dissakamajaya/cp-100/work/component-photos/esp32.jpg

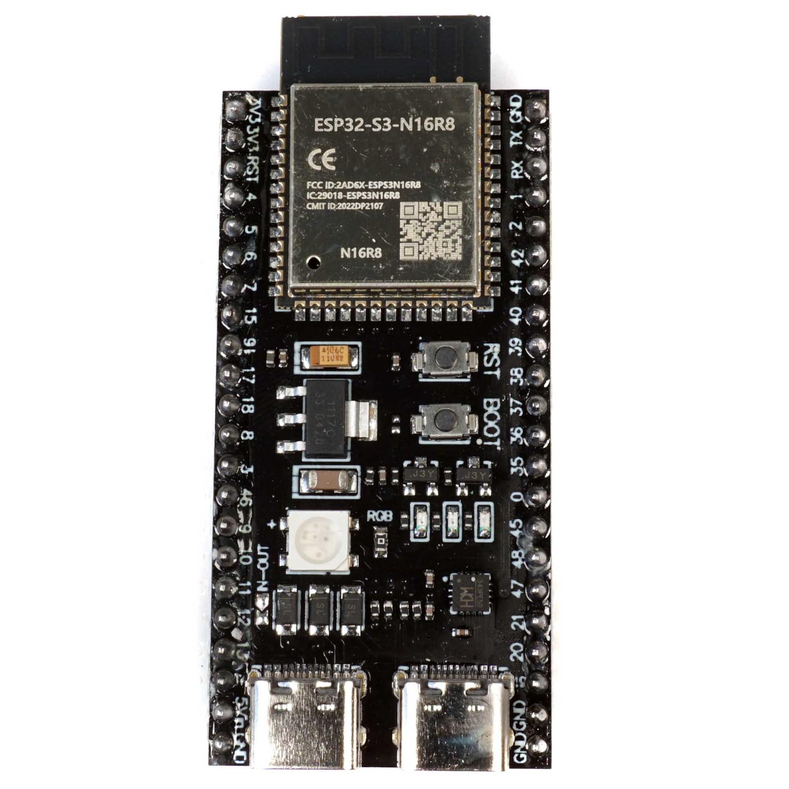
work/component-photos/esp32.jpg
