dissakamajaya/cp-100/work/component-photos/selector.jpg

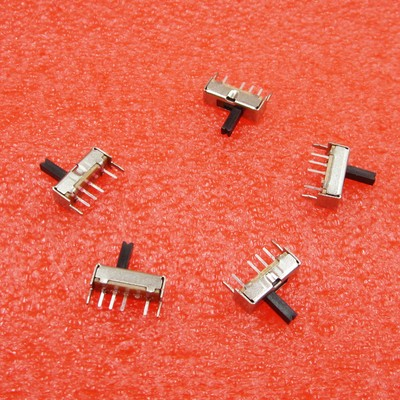
work/component-photos/selector.jpg
