dissakamajaya/cp-100/evidence/README.md

# Evidence

`packaging-verification.json` records verification on 26 October 2026: 29/29 Node tests, 80 source asset checksums, 32 photo path resolutions, and a successful isolated PDF rebuild (14 pages, 25 cutout features). All rebuilt page text matched the original. The original PDF remains packaged to preserve the exact incomplete revision.

No current live UI or physical hardware validation was performed. `historical/` contains previous-session QA artifacts and is not a new test result. The old QA script paths referenced in historical JSON belong to the source workspace; consult HANDOFF.md and rerun with Stagehand for current browser evidence.
