dissakamajaya/cp-100/evidence/enclosure-4-pad-2026-10-30/README.md

# Four-pad enclosure verification — 30 October 2026

Geometry PASS: node evidence/enclosure-4-pad-2026-10-30/verify-geometry.mjs; artifact geometry-results.json. Seven printable part types are valid single solids, STL byte counts pass, four caps have no housing/neighbour collision, service geometry unchanged.

Preview PASS: stagehand-run /Users/0xtx/Documents/GitHub/cp-100/evidence/enclosure-4-pad-2026-10-30/verify-preview.mjs (server: node enclosure/serve.mjs 5181). Stagehand completed; assembled and exploded images visually inspected. Artifacts retained: pad-assembled.png, pad-exploded.png. Front/underside screenshots discarded to recover space after filesystem became full during final notes.

Baseline PASS before editing: node --test simulator/tests/*.test.js domain-router/worker.test.mjs (44/44); python3 scripts/verify_manifest.py (86 assets, rechecked after edits). Existing working-tree changes preserved.

Result: four pads, default 2×2, 124×122×24 mm housing; faces 40×40 mm; pitch 48 mm. ZIP: enclosure/CP-100-4-pad-STLs.zip. One cap mesh: print four copies. Eight-pad STLs archived under enclosure/stl/legacy-8-pad/.

No physical print/hardware verification. Firmware, simulator and PDF remain eight-pad. No commit, push or deployment.
