dissakamajaya/cp-100/outputs/CP-100-Rev08-Blueprint/README.txt

CP-100 REV08 - REFERENCE PROTOTYPE
Units mm. SVG and A3 PDF front view: origin top-left; X right, Y down. DXF uses bottom-left, Y up. CUT layer includes panel perimeter and holes; no kerf compensation.
Panel material: 2mm black aluminium. Cutouts +/-0.2mm; centers +/-0.2mm proposed. Deburr; match units before full fabrication.
Custom cap, frame, spring, carrier and PCB need prototype fit checks. This package does not include Gerbers or production-ready 3D parts. See main PDF for assembly stack and part basis.
