dissakamajaya/cp-100/outputs/CP-100-Rev08-Blueprint/CP-100-Panel-Templates-1to1-A3.pdf

### CP-100 / VISITOR / REV08 / mm / 1:1

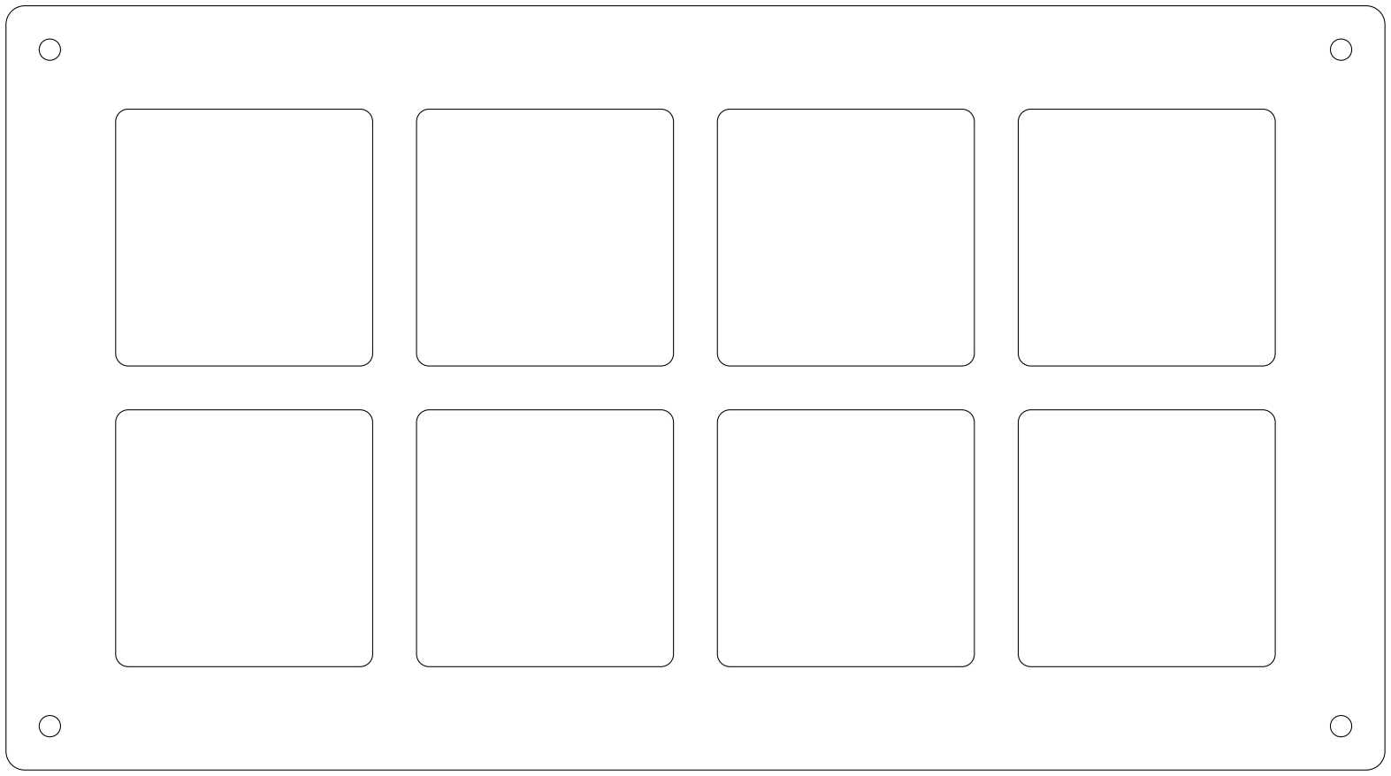
[picture p3: figure]

CHECK 50 x 50 mm

Print 100% / Actual size. No Fit to page. Front view, datum top-left.

Prototype reference. Match actual components before cutting.

### CP-100 / SERVICE / REV08 / mm / 1:1

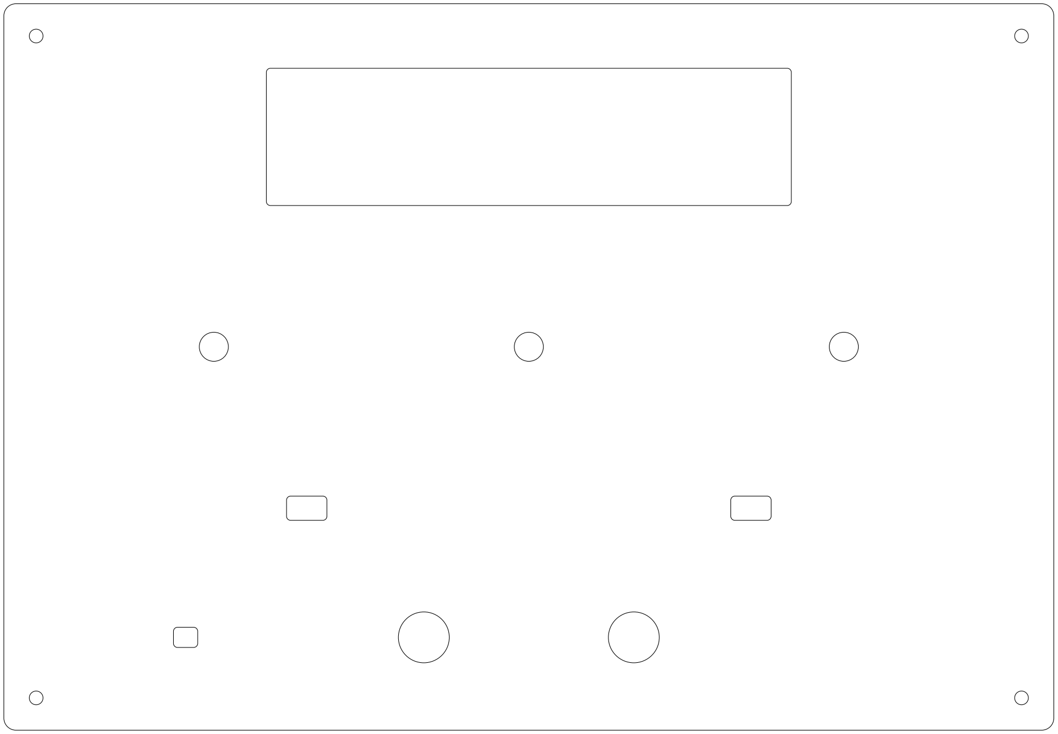
[picture p4: figure]

CHECK 50 x 50 mm

Print 100% / Actual size. No Fit to page. Front view, datum top-left.

Prototype reference. Match actual components before cutting.
