dissakamajaya/cp-100/evidence/audio-boost-2026-10-26/live-before.png

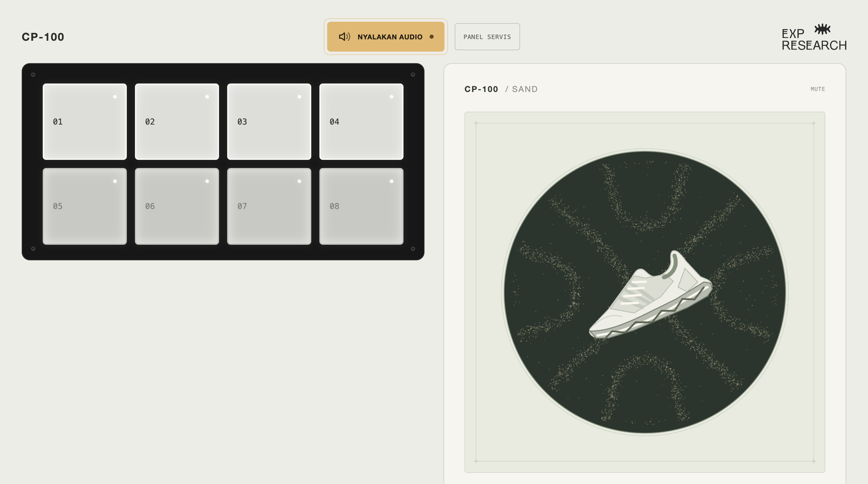
evidence/audio-boost-2026-10-26/live-before.png
