dissakamajaya/cp-100/evidence/diagram-esp32-2026-10-26/artifact.png

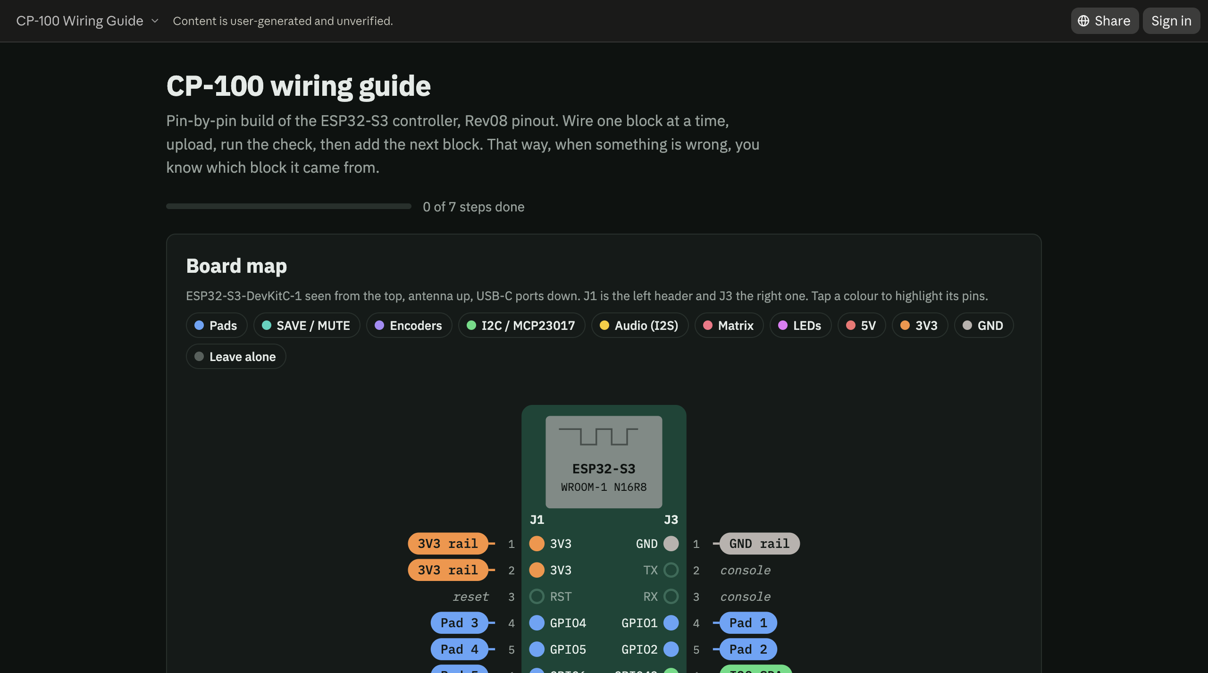
evidence/diagram-esp32-2026-10-26/artifact.png
