dissakamajaya/cp-100/evidence/enclosure-4-pad-2026-10-30/pad-exploded.png

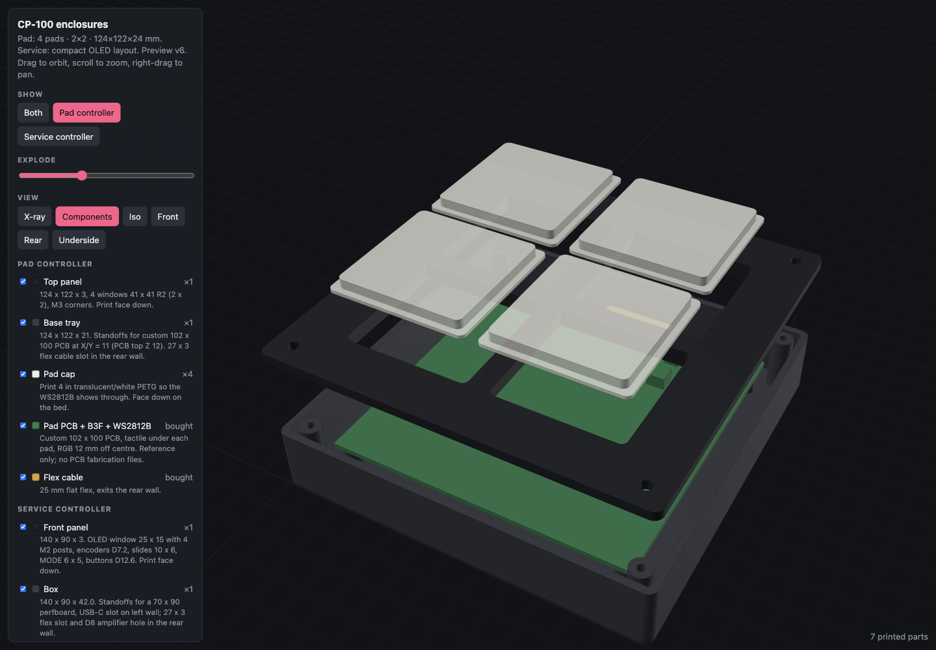
evidence/enclosure-4-pad-2026-10-30/pad-exploded.png
