dissakamajaya/cp-100/evidence/enclosure-4-pad-row-2026-10-30/pad-underside.png

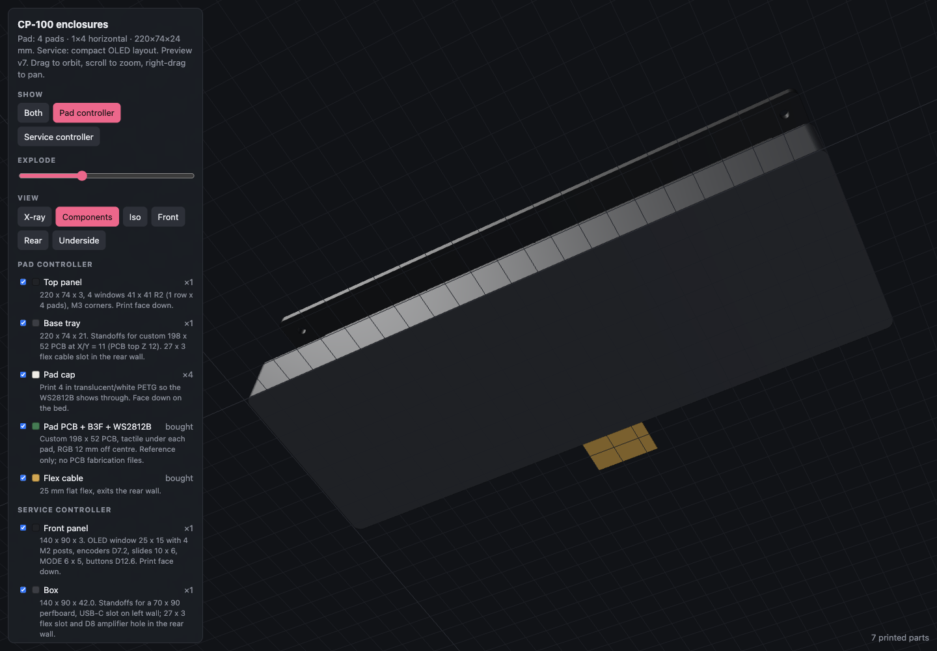
evidence/enclosure-4-pad-row-2026-10-30/pad-underside.png
