dissakamajaya/cp-100/evidence/enclosure-2026-10-27/preview-pad-underside.png

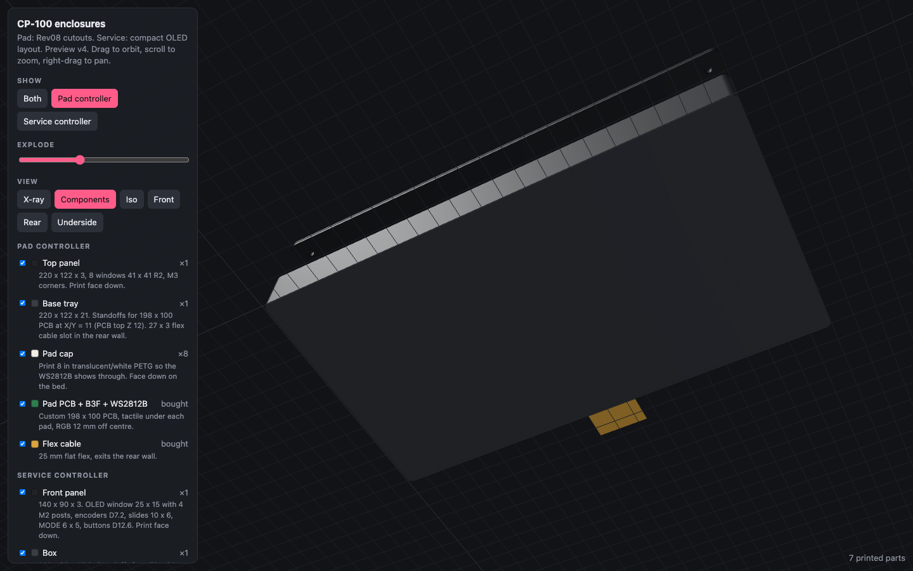
evidence/enclosure-2026-10-27/preview-pad-underside.png
