dissakamajaya/cp-100/evidence/gather-2026-10-28/live-mobile.png

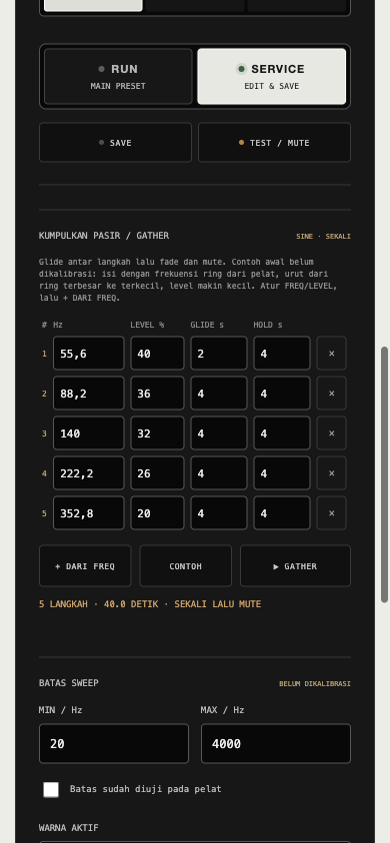
evidence/gather-2026-10-28/live-mobile.png
