dissakamajaya/cp-100/evidence/historical/domain-route/domain-smoke.png

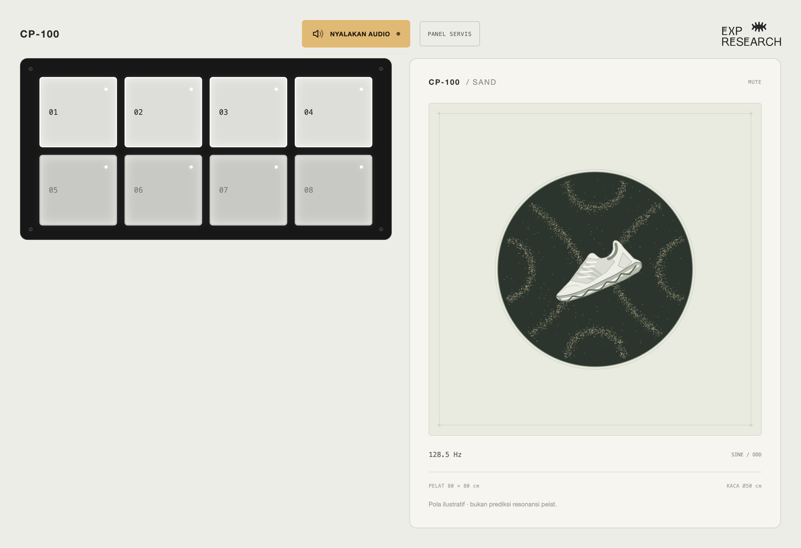
evidence/historical/domain-route/domain-smoke.png
