dissakamajaya/cp-100/evidence/historical/domain-route/momentary-held.png

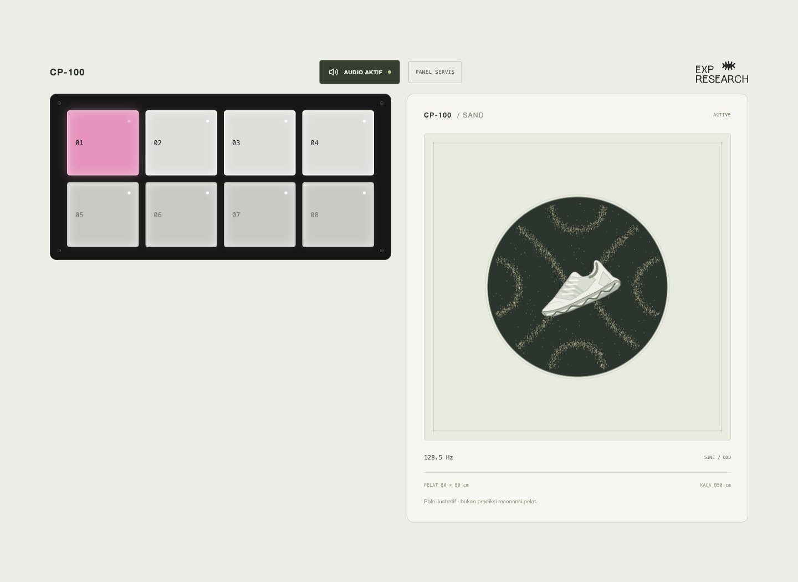
evidence/historical/domain-route/momentary-held.png
