dissakamajaya/cp-100/evidence/historical/domain-route/momentary-mobile.png

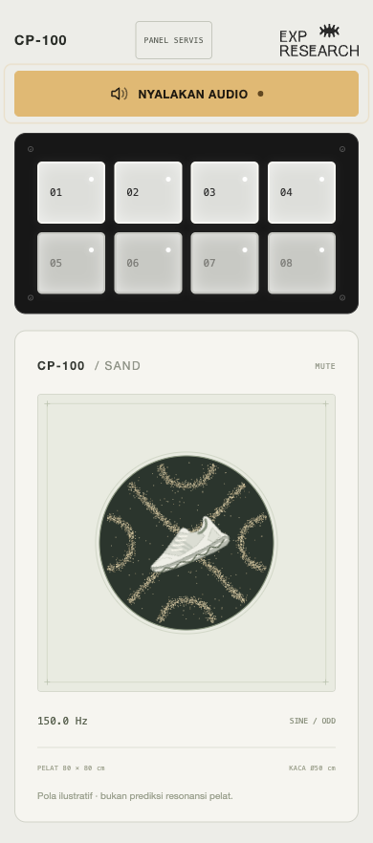
evidence/historical/domain-route/momentary-mobile.png
