dissakamajaya/cp-100/evidence/historical/rev7-review/mobile.png

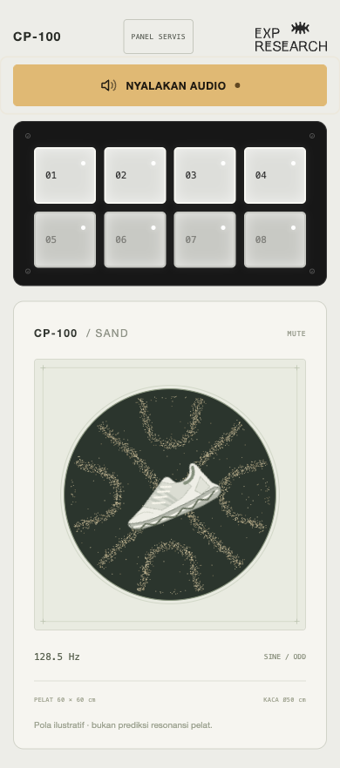
evidence/historical/rev7-review/mobile.png
