dissakamajaya/cp-100/evidence/momentary-2026-11-01/mobile-presets.png

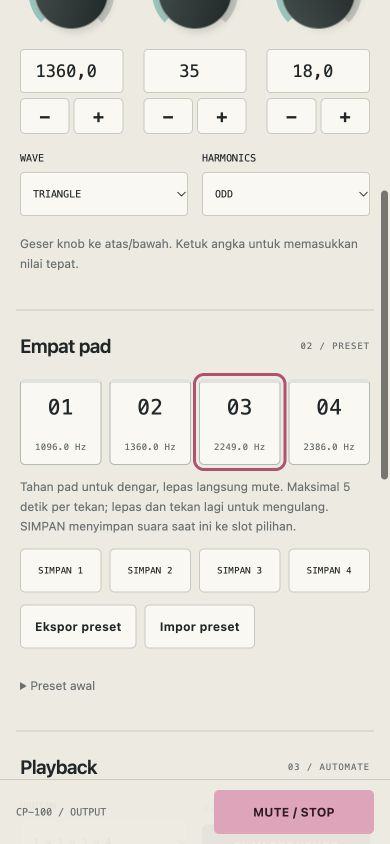
evidence/momentary-2026-11-01/mobile-presets.png
