dissakamajaya/cp-100/evidence/momentary-2026-11-01/pdf-6.png

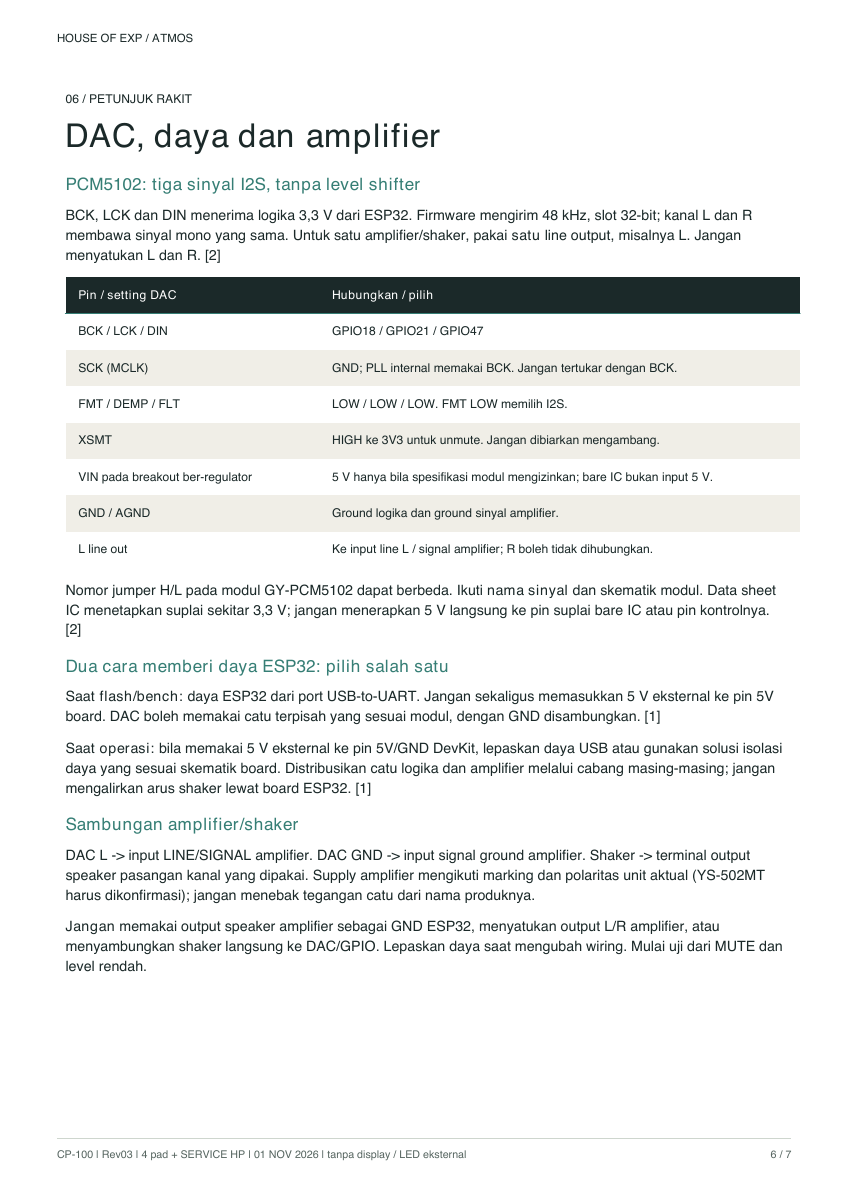
evidence/momentary-2026-11-01/pdf-6.png
