dissakamajaya/cp-100/evidence/release-2026-11-01/mobile-minimal.png

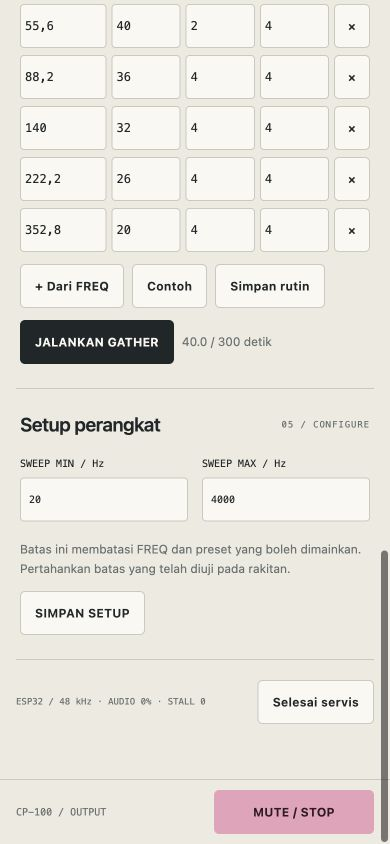
evidence/release-2026-11-01/mobile-minimal.png
