dissakamajaya/cp-100/evidence/remote-service-2026-10-31/mobile-panel-final.png

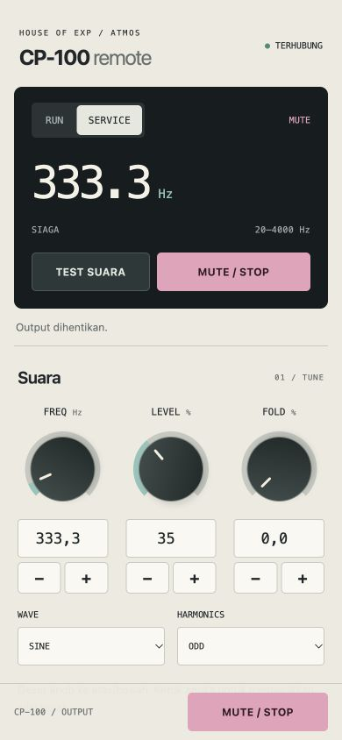
evidence/remote-service-2026-10-31/mobile-panel-final.png
