dissakamajaya/cp-100/evidence/sequencer-2026-10-26/live-desktop.png

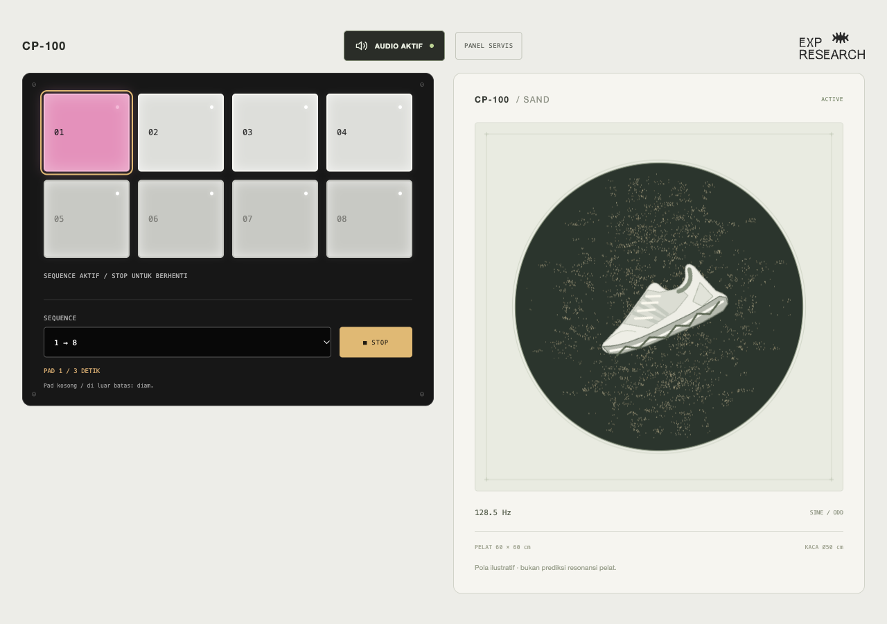
evidence/sequencer-2026-10-26/live-desktop.png
