dissakamajaya/cp-100/outputs/Chladni-08-Visual-Rev03.png

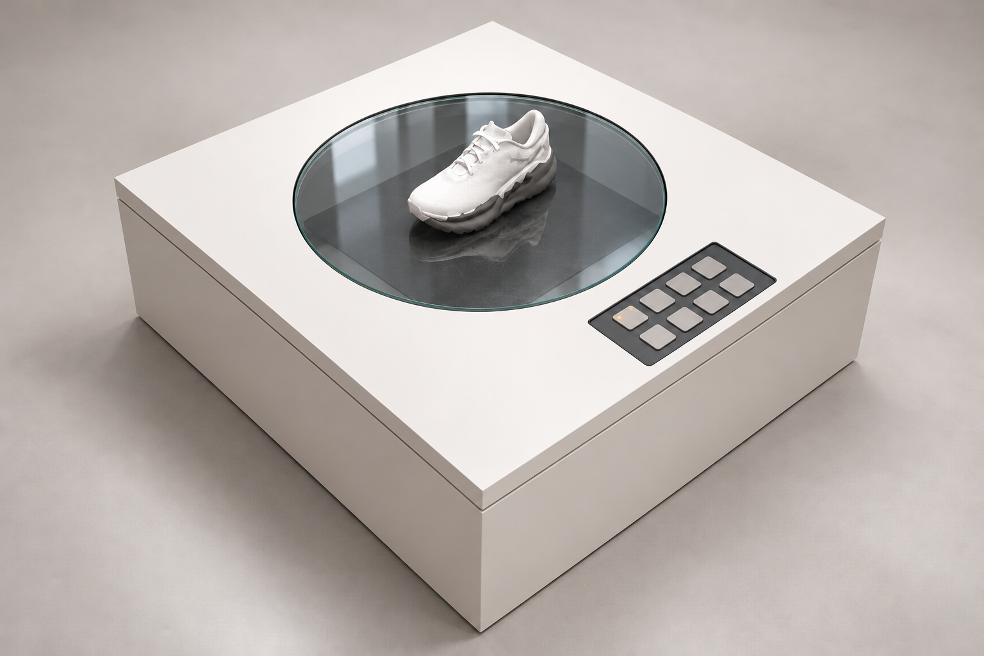
outputs/Chladni-08-Visual-Rev03.png
