dissakamajaya/cp-100/work/rev8/final-contact-0.png

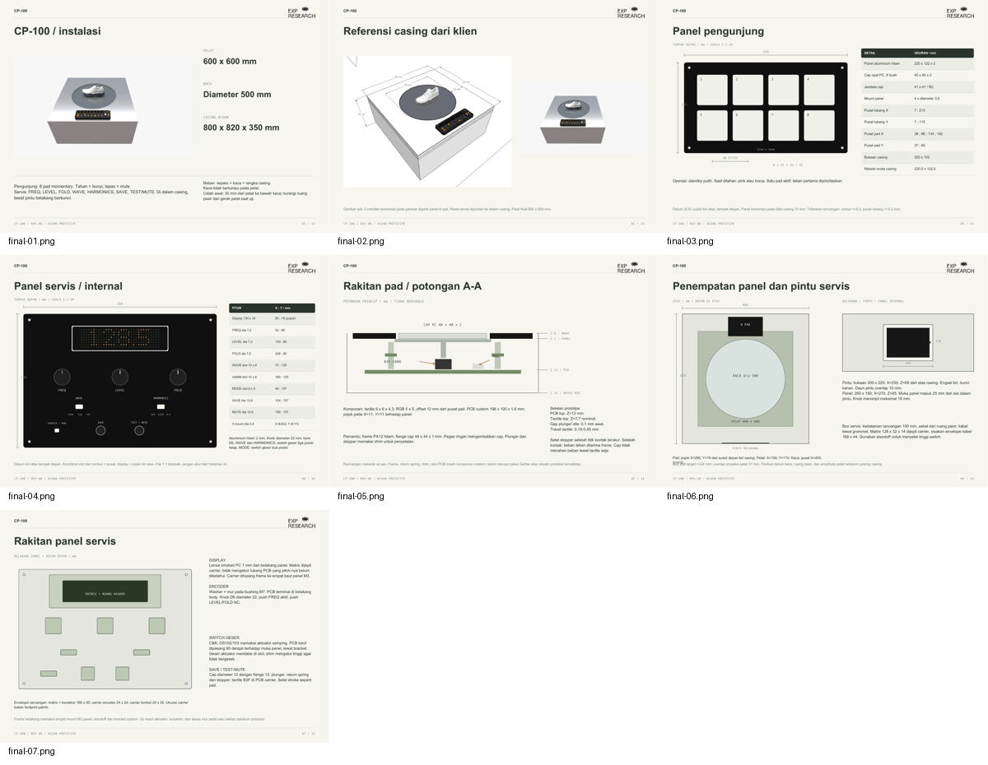
work/rev8/final-contact-0.png
