dissakamajaya/cp-100/work/rev8/final-contact-1.png

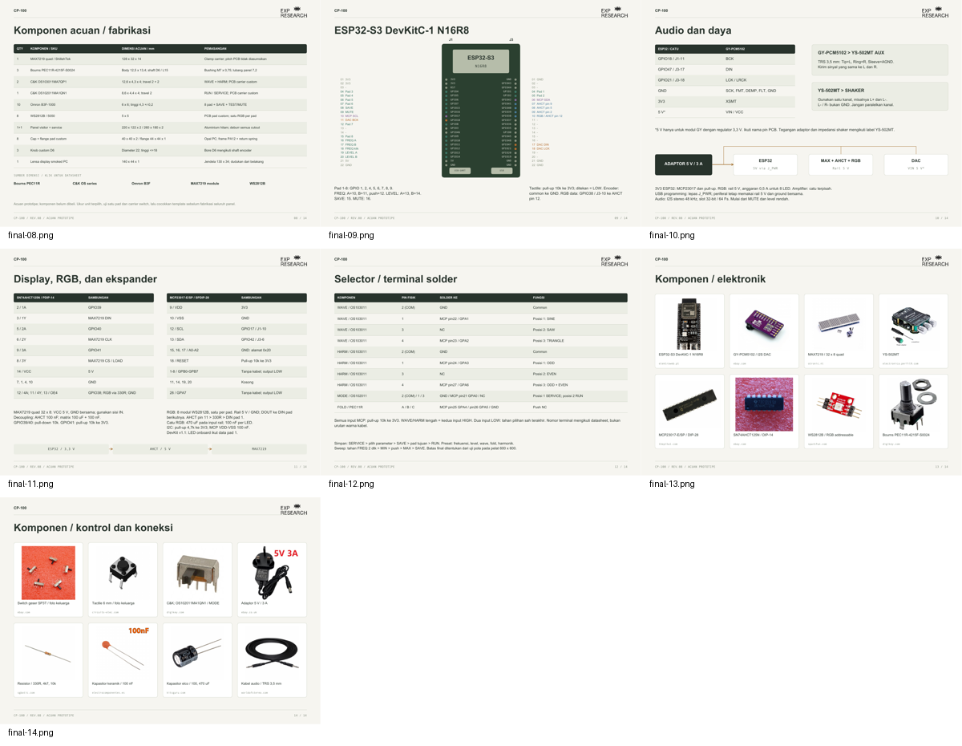
work/rev8/final-contact-1.png
