dissakamajaya/cp-100/work/rev8/reference-dimensions.png

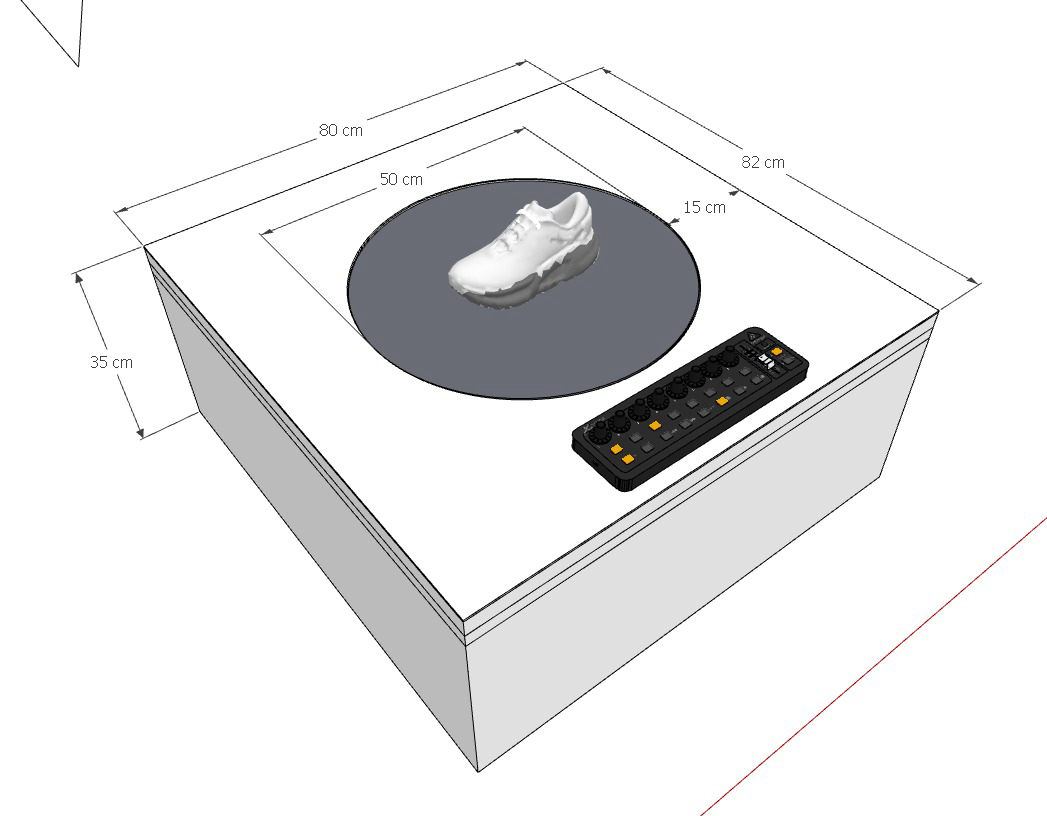
work/rev8/reference-dimensions.png
