dissakamajaya/cp-100/work/rev8/reference-render.png

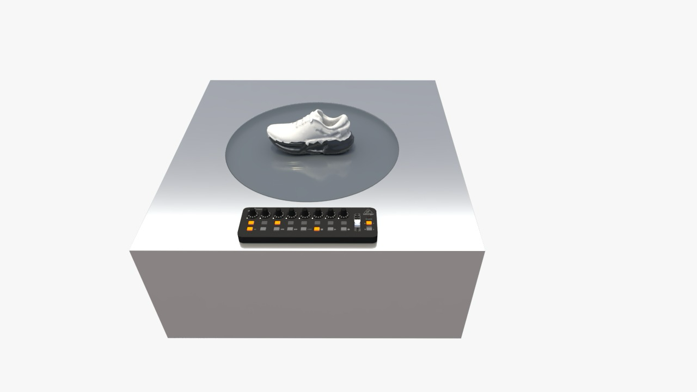
work/rev8/reference-render.png
