dissakamajaya/cp-100/work/rev8/sources/alps-08.png

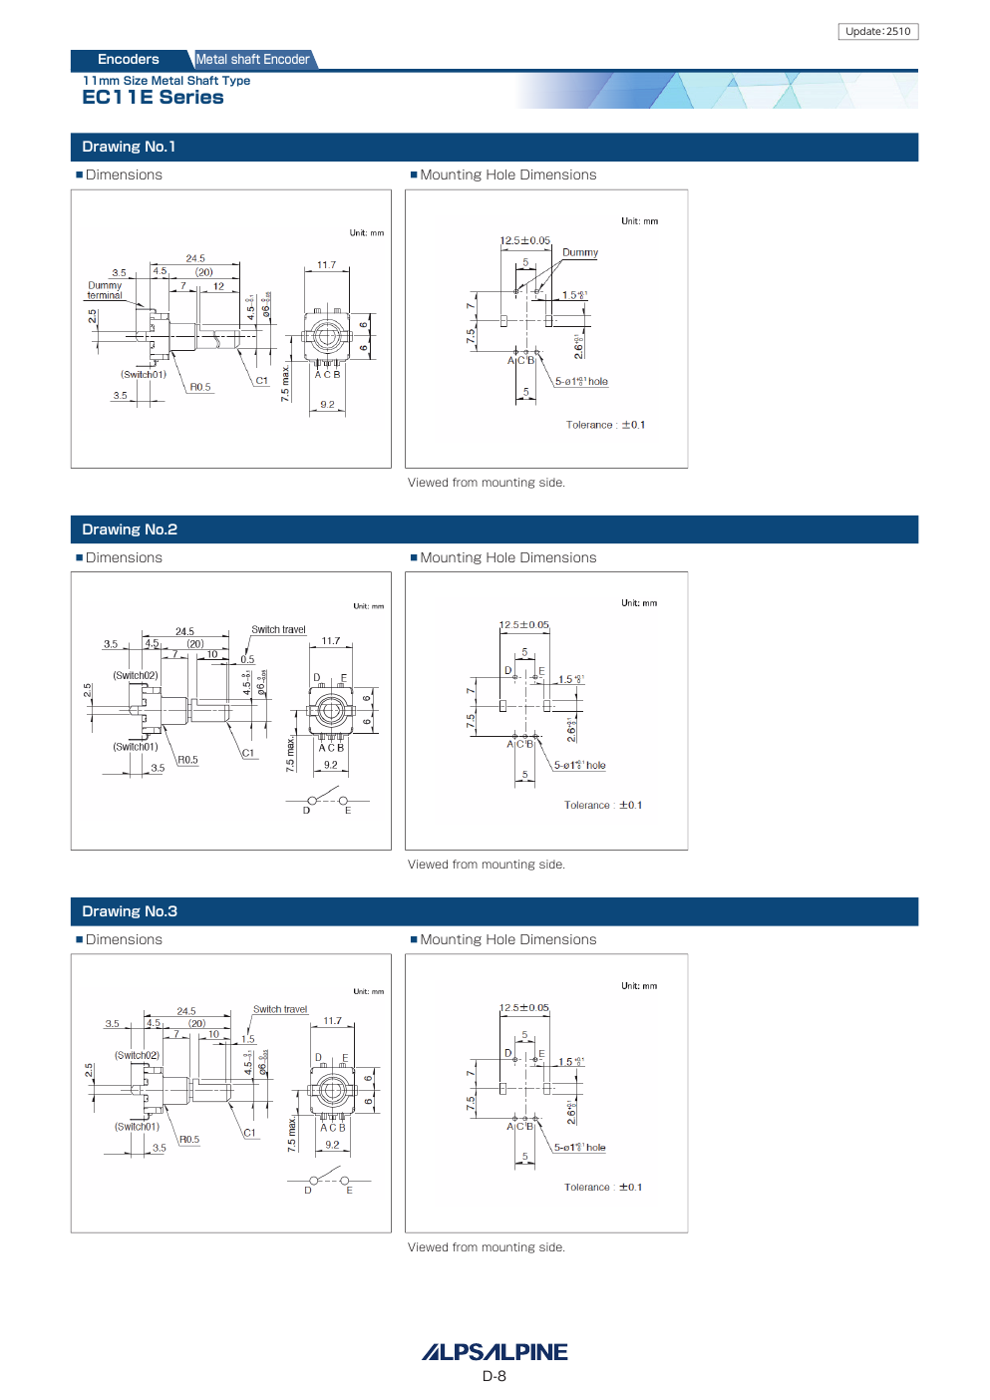
work/rev8/sources/alps-08.png
