dissakamajaya/cp-100/work/rev8/sources/bourns-1.png

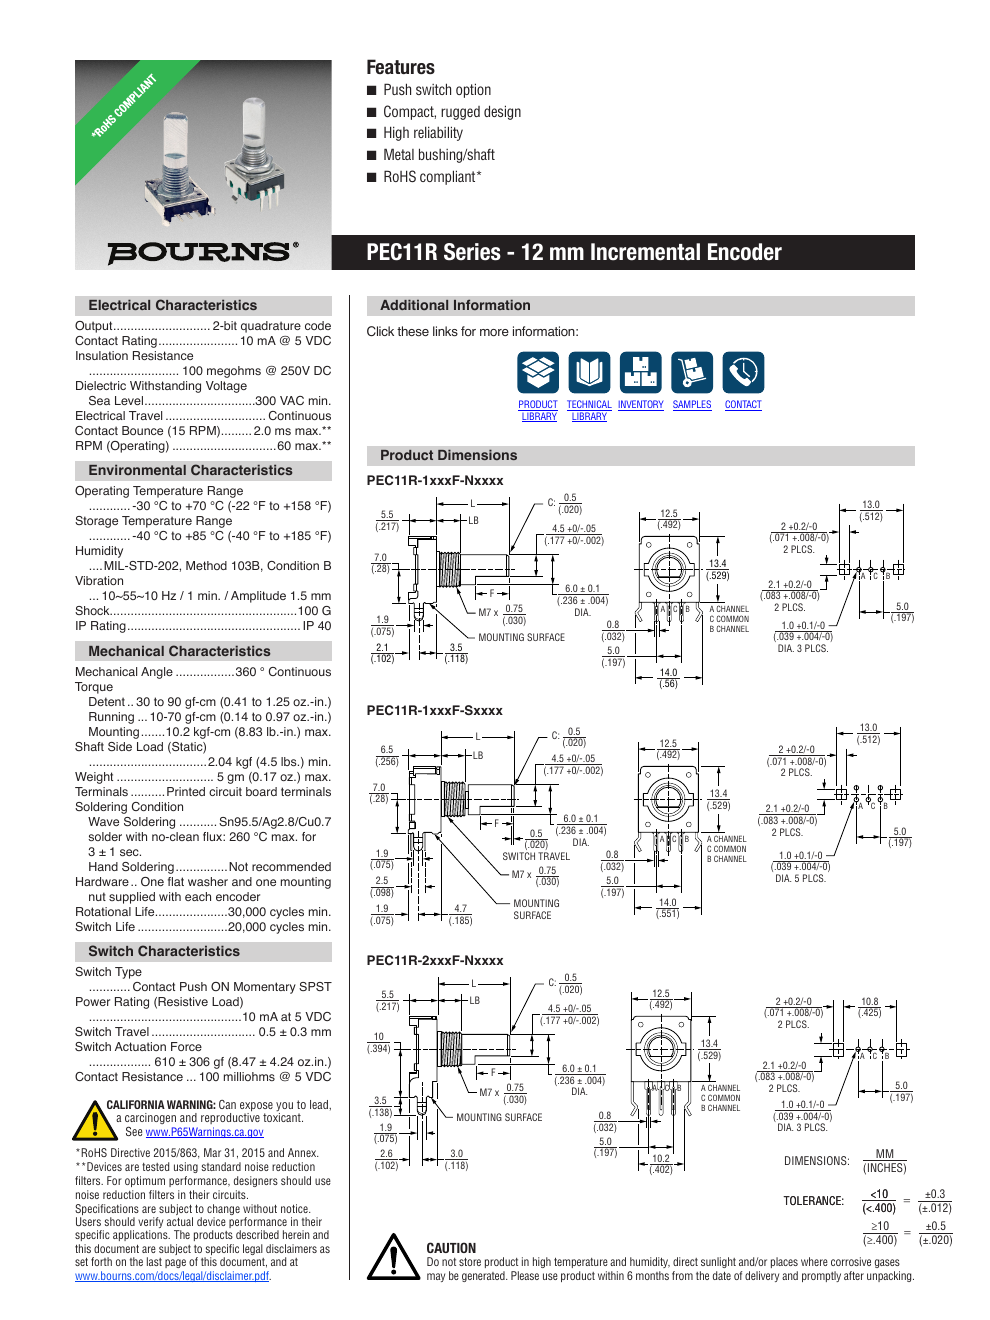
work/rev8/sources/bourns-1.png
