dissakamajaya/cp-100/work/rev8/sources/os102.jpg

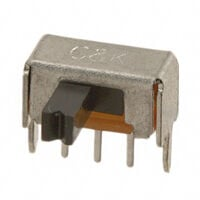
work/rev8/sources/os102.jpg
