dissakamajaya/cp-100/work/rev8/sources/pec11r.jpg

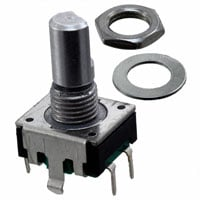
work/rev8/sources/pec11r.jpg
