dissakamajaya/cp-100/work/rev8/sources/tactile-4.png

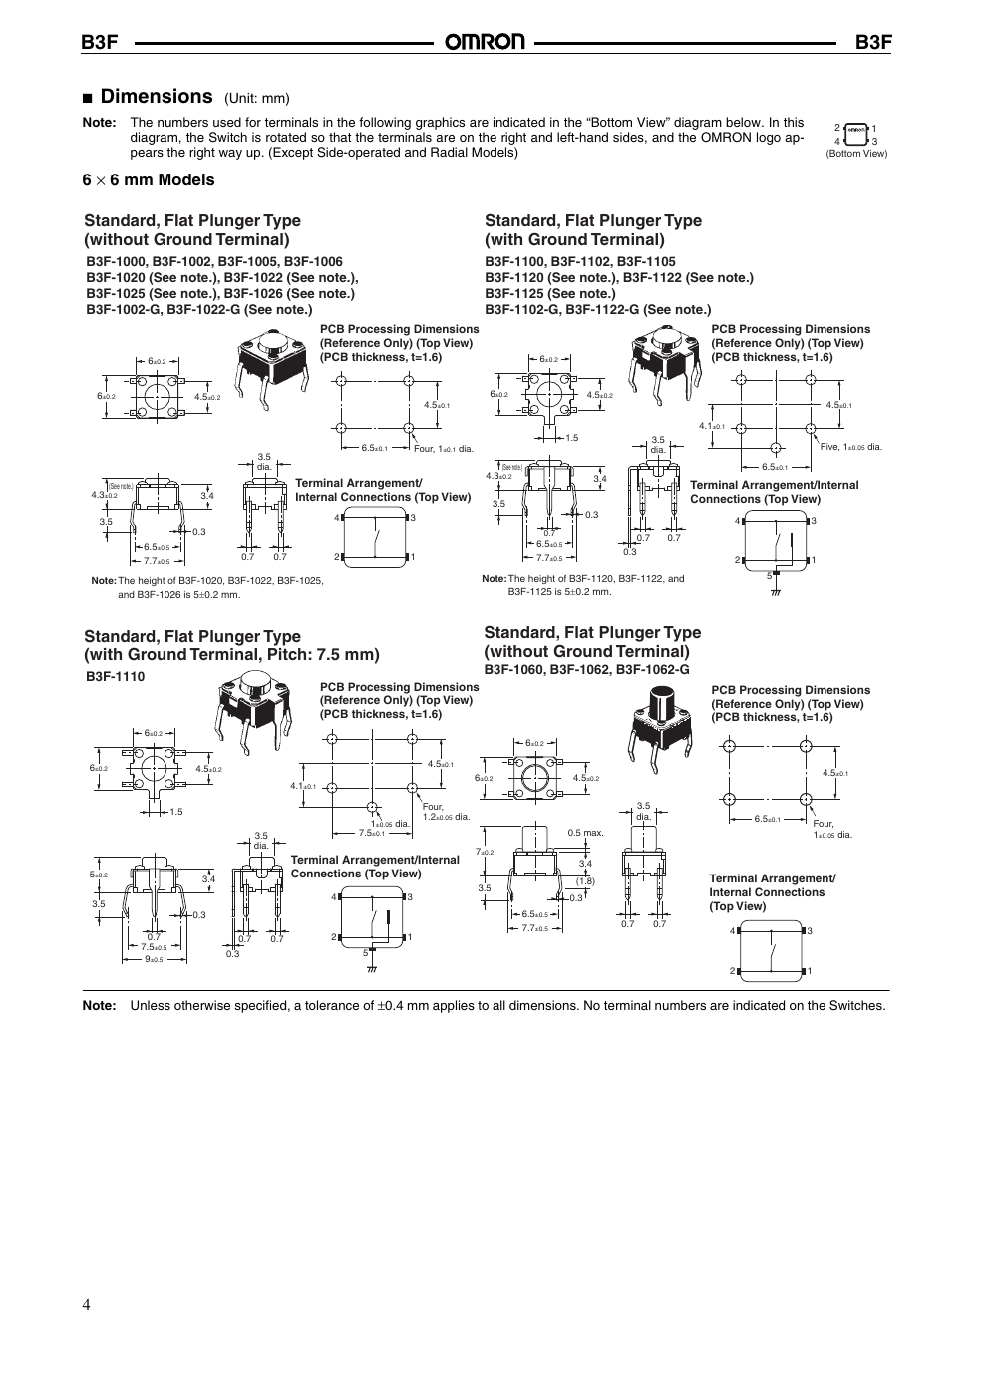
work/rev8/sources/tactile-4.png
