dissakamajaya/cp-100/work/component-photos/ahct.jpg

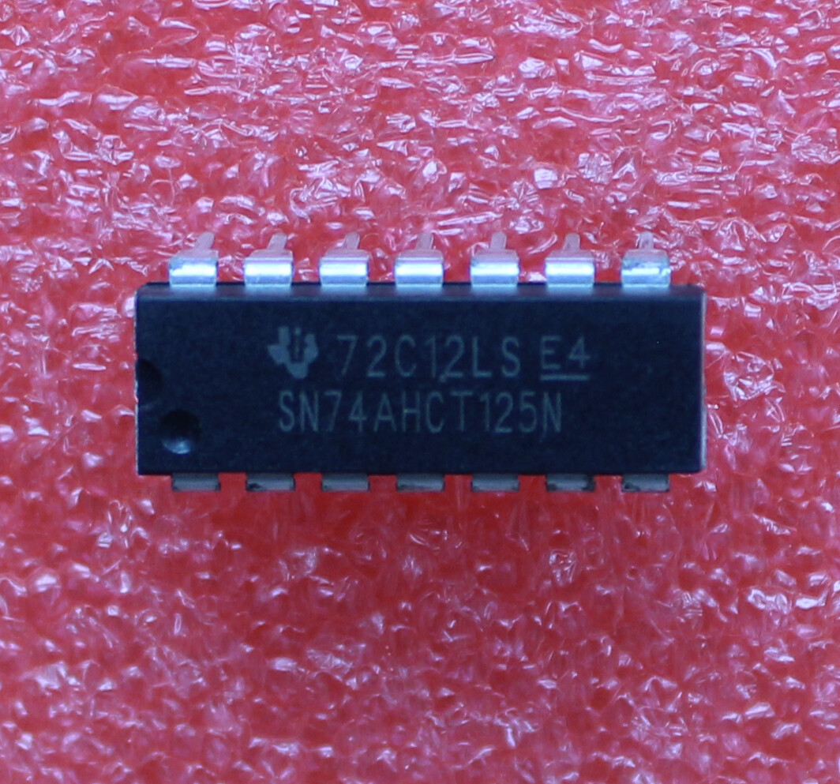
work/component-photos/ahct.jpg
