dissakamajaya/cp-100/work/component-photos/amp-01.jpg

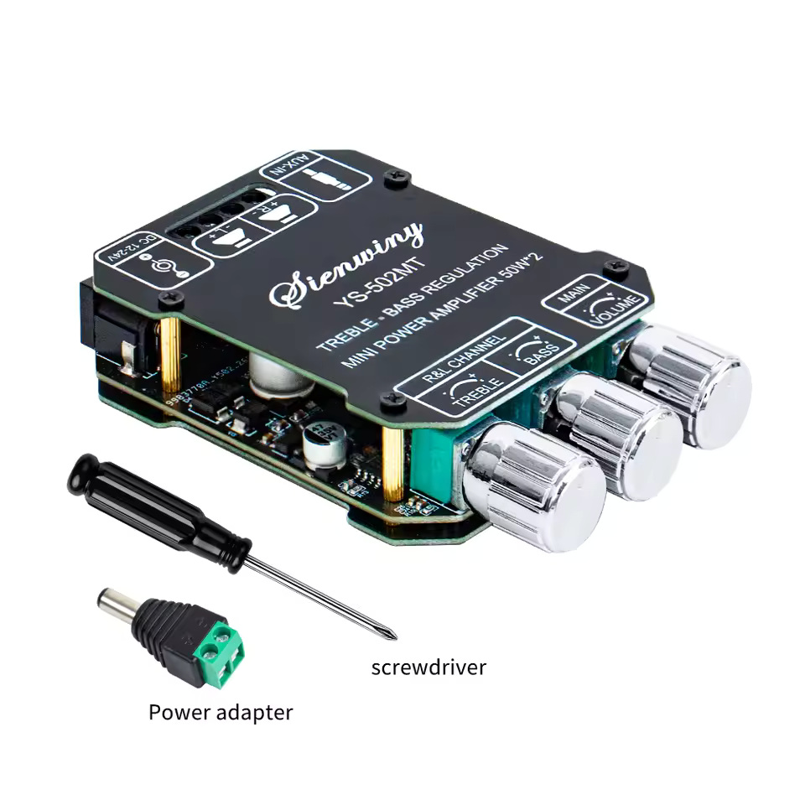
work/component-photos/amp-01.jpg
