dissakamajaya/cp-100/work/component-photos/amp-02.jpg

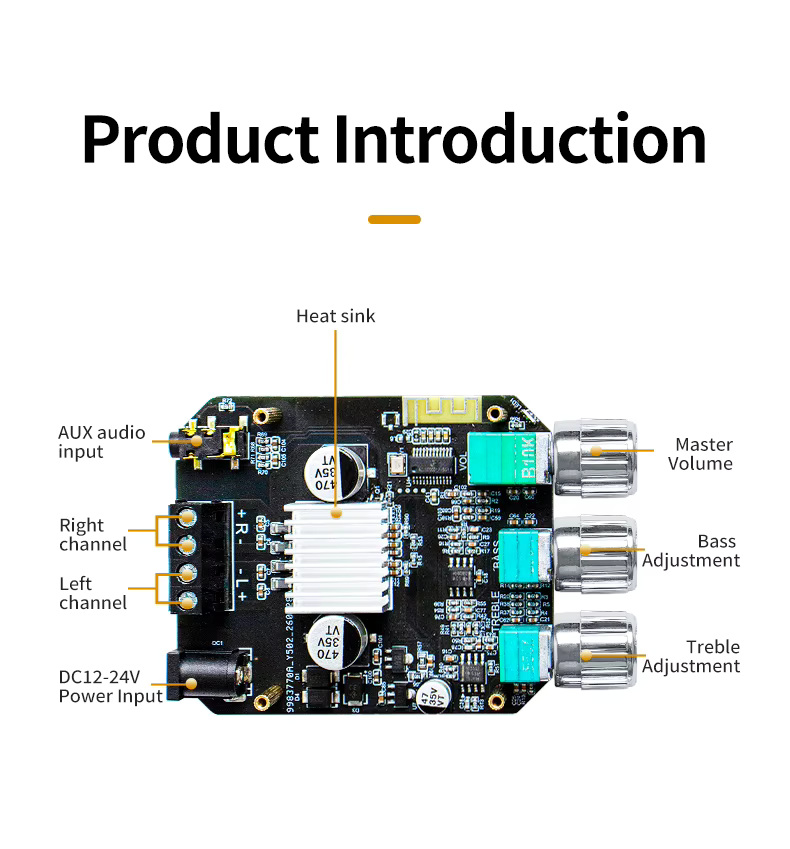
work/component-photos/amp-02.jpg
