dissakamajaya/cp-100/work/component-photos/amp.jpg

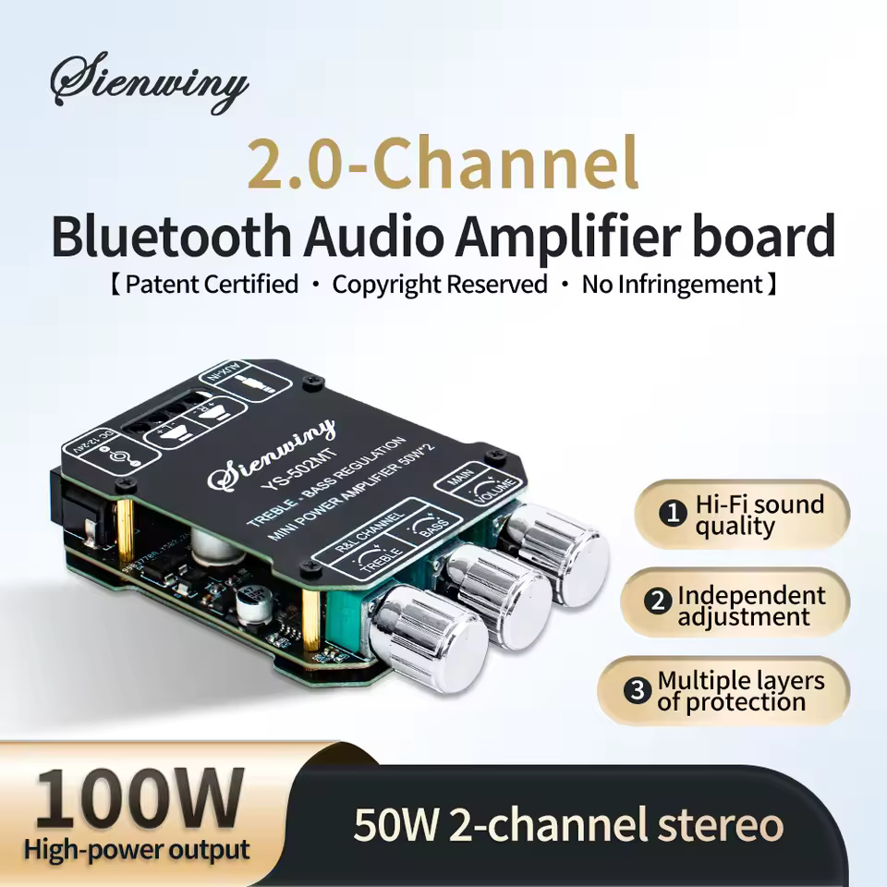
work/component-photos/amp.jpg
