dissakamajaya/cp-100/work/component-photos/ceramic.jpg

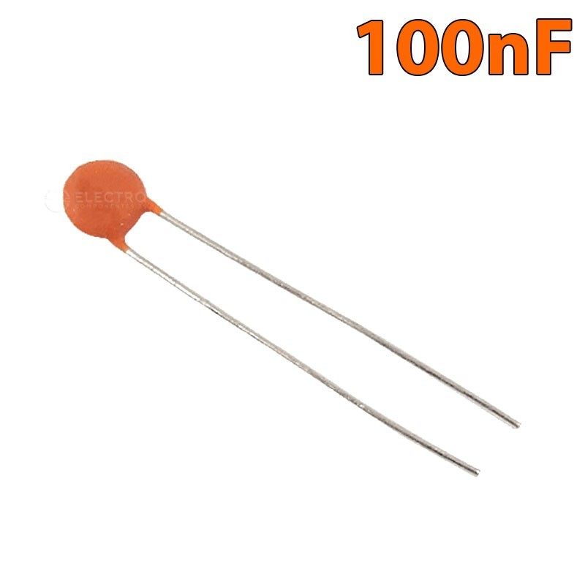
work/component-photos/ceramic.jpg
