dissakamajaya/cp-100/work/component-photos/dac.jpg

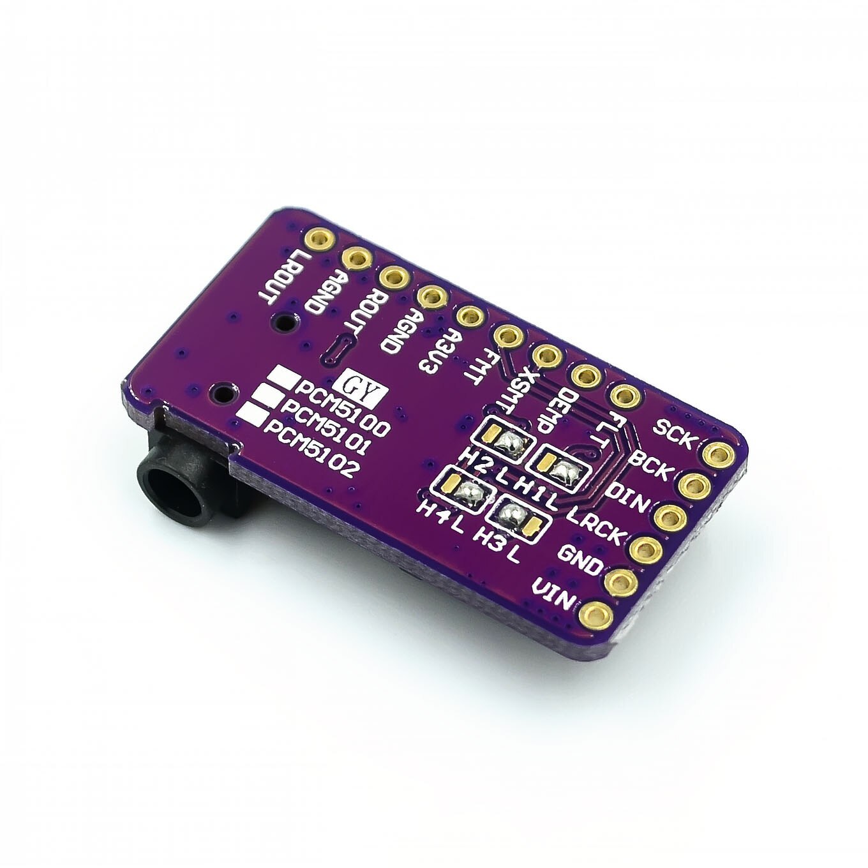
work/component-photos/dac.jpg
