dissakamajaya/cp-100/work/component-photos/elco.jpg

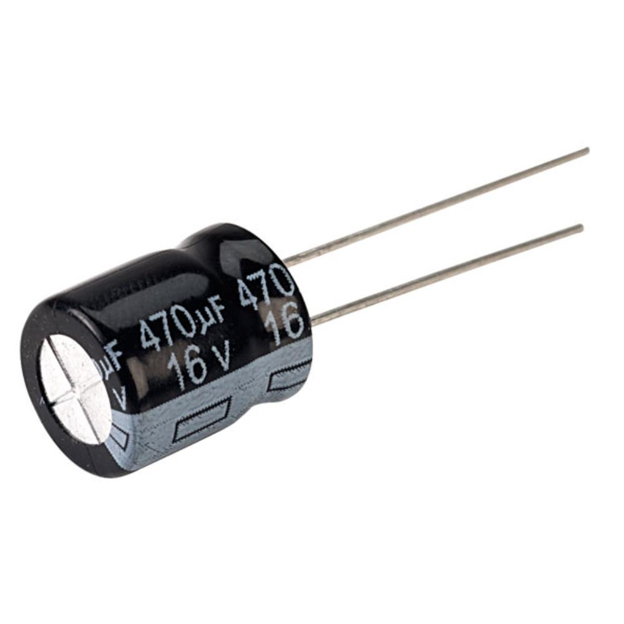
work/component-photos/elco.jpg
