dissakamajaya/cp-100/work/component-photos/encoder.jpg

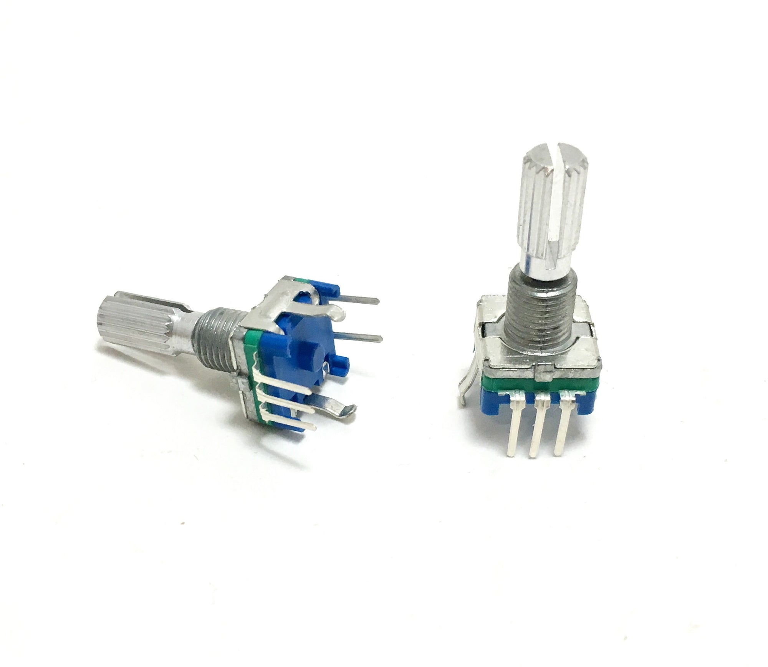
work/component-photos/encoder.jpg
