dissakamajaya/cp-100/work/component-photos/matrix.jpg

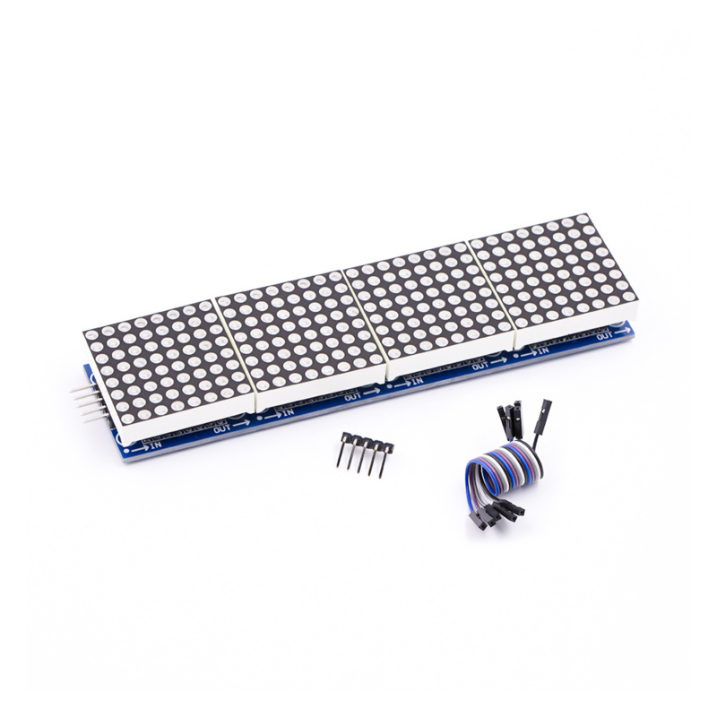
work/component-photos/matrix.jpg
