dissakamajaya/cp-100/work/component-photos/mcp.jpg

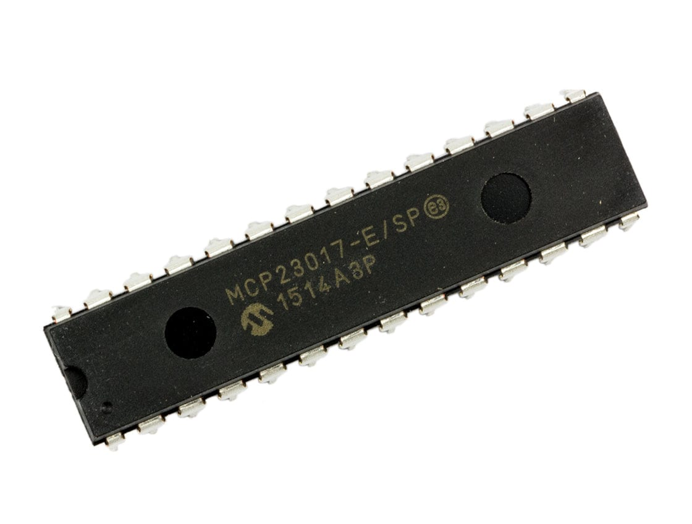
work/component-photos/mcp.jpg
