dissakamajaya/cp-100/work/component-photos/power.jpg

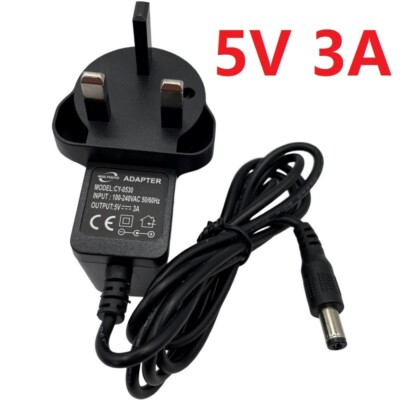
work/component-photos/power.jpg
