dissakamajaya/cp-100/work/component-photos/resistor.jpg

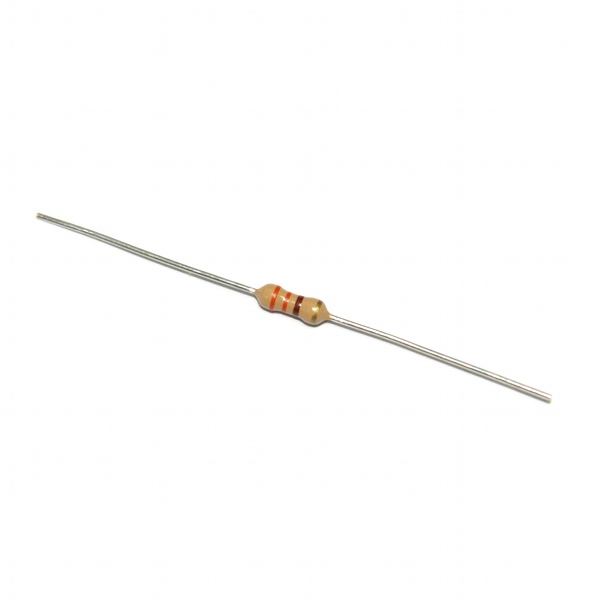
work/component-photos/resistor.jpg
