dissakamajaya/cp-100/work/component-photos/rgb.jpg

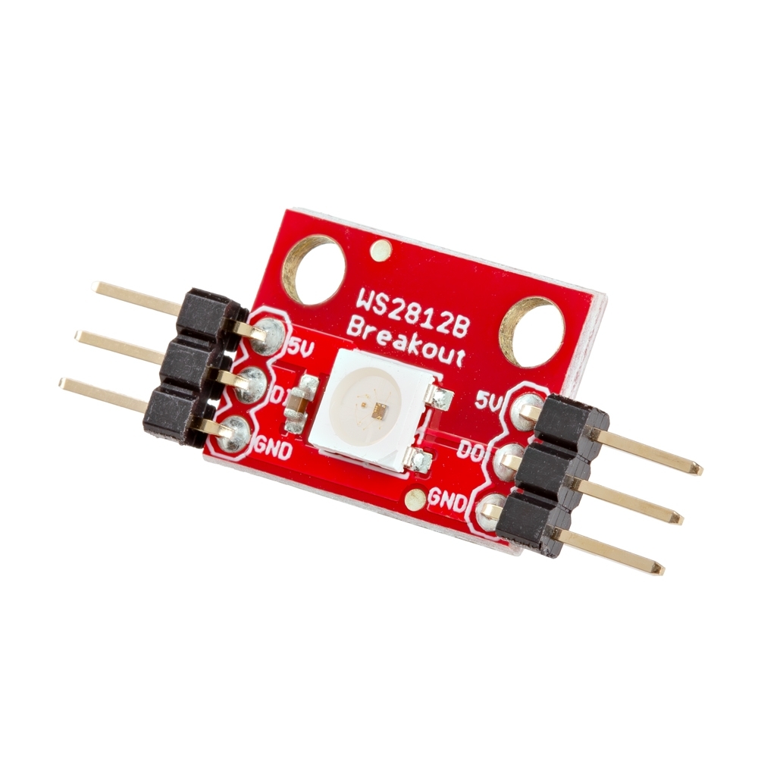
work/component-photos/rgb.jpg
