dissakamajaya/cp-100/work/component-photos/tactile.jpg

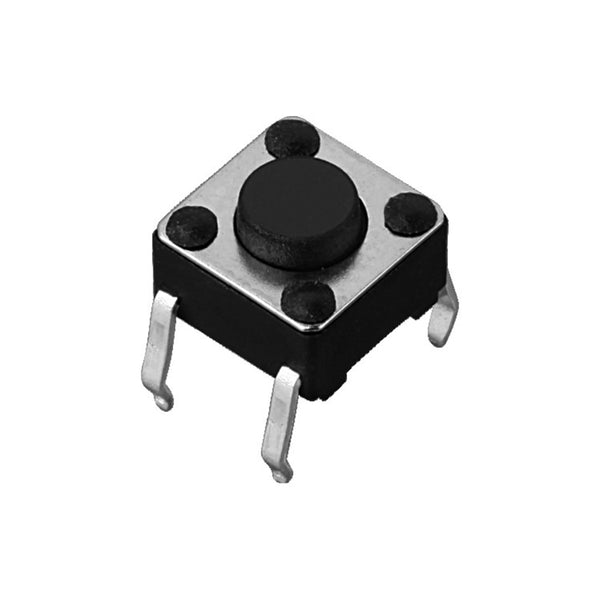
work/component-photos/tactile.jpg
