dissakamajaya/cp-100/work/component-photos/toggle.jpg

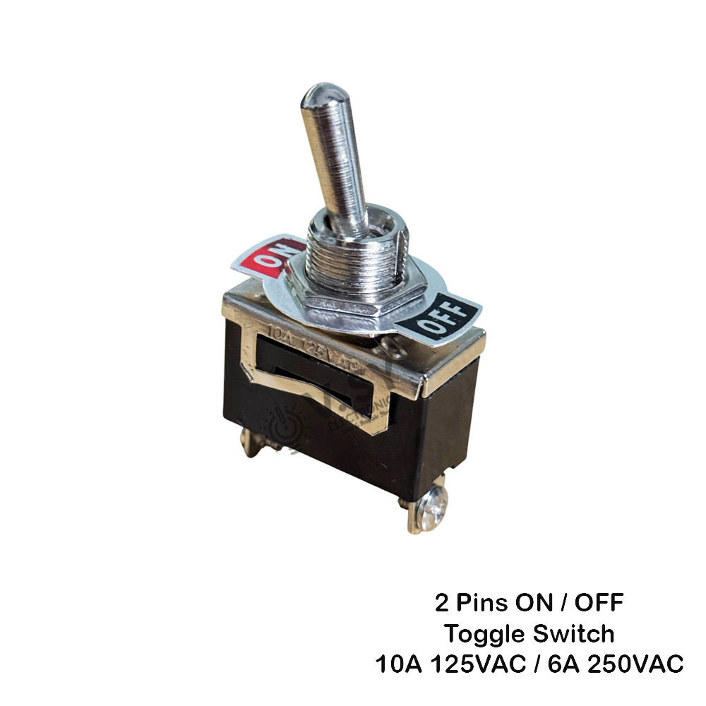
work/component-photos/toggle.jpg
