dissakamajaya/cp-100/work/component-photos/trs.jpg

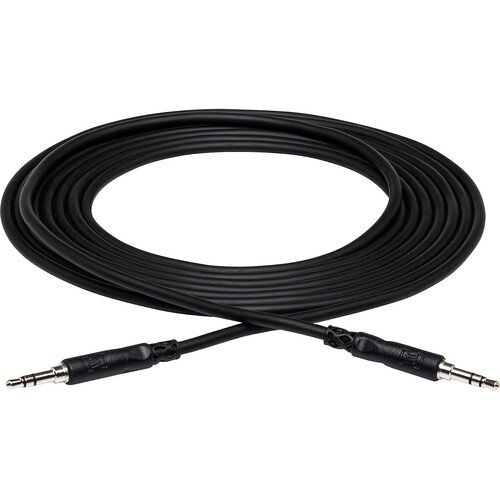
work/component-photos/trs.jpg
