dissakamajaya/cp-100/enclosure/print-ready/CP-100-4-pad-horizontal-PRINT.stl

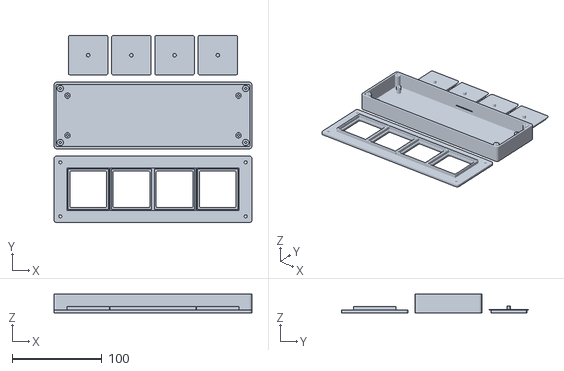
[picture p63: CAD file, 2026-11-01]
enclosure/print-ready/CP-100-4-pad-horizontal-PRINT.stl
220.0 x 208.0 x 21.0
