dissakamajaya/cp-100/enclosure/stl/CP-100-pad-top.stl

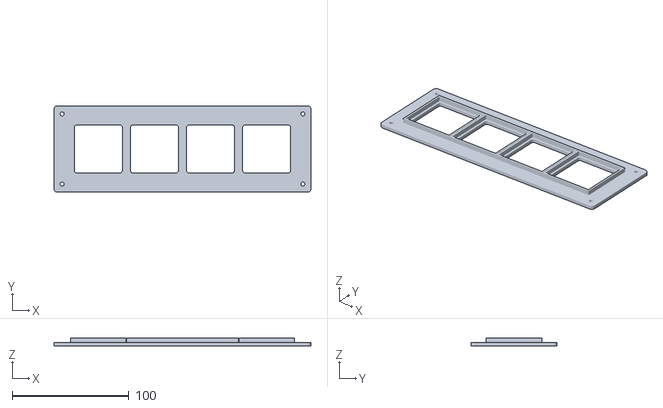
[picture p64: CAD file, 2026-11-01]
enclosure/stl/CP-100-pad-top.stl
220.0 x 74.0 x 7.00
