dissakamajaya/cp-100/outputs/CP-100-Rev08-Blueprint/service-cutout-1to1.dxf

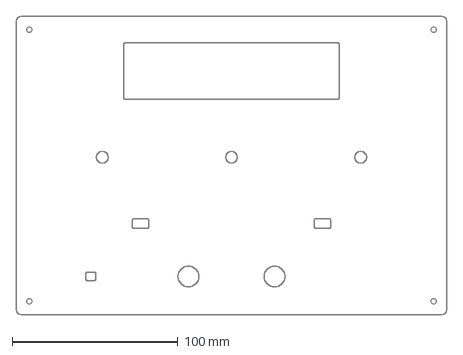
[picture p65: CAD file, 2026-10-26]
outputs/CP-100-Rev08-Blueprint/service-cutout-1to1.dxf
260.0 x 180.0 mm
