dissakamajaya/cp-100/enclosure/print-ready/CP-100-housing-PRINT.stl

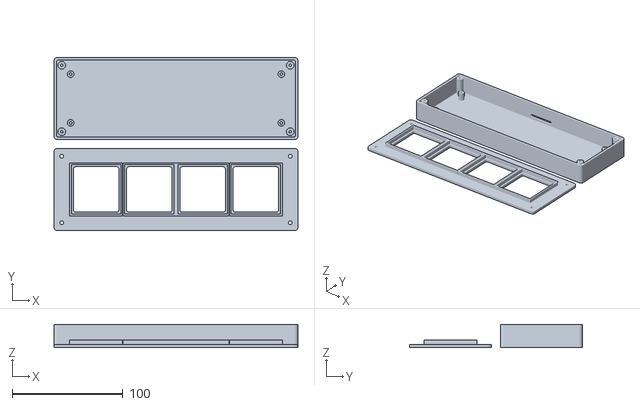
[picture p66: CAD file, 2026-11-01]
enclosure/print-ready/CP-100-housing-PRINT.stl
220.0 x 156.0 x 21.0
