dissakamajaya/cp-100/enclosure/stl/CP-100-svc-panel.stl

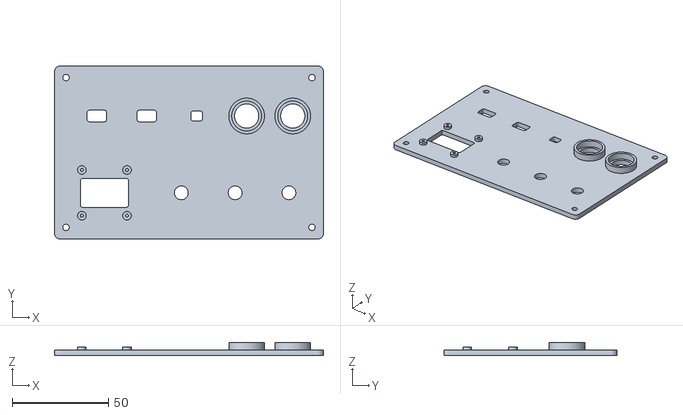
[picture p67: CAD file, 2026-11-01]
enclosure/stl/CP-100-svc-panel.stl
140.0 x 90.0 x 7.00
