dissakamajaya/cp-100/outputs/CP-100-Rev08-Blueprint/visitor-cutout-1to1.dxf

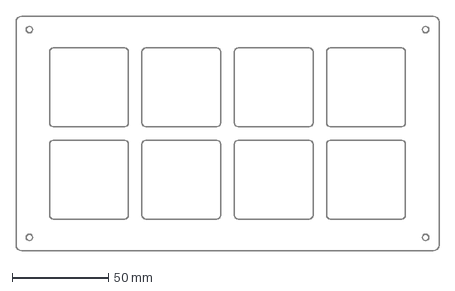
[picture p68: CAD file, 2026-10-26]
outputs/CP-100-Rev08-Blueprint/visitor-cutout-1to1.dxf
220.0 x 122.0 mm
