dissakamajaya/cp-100/enclosure/print-ready/CP-100-four-caps-PRINT.stl

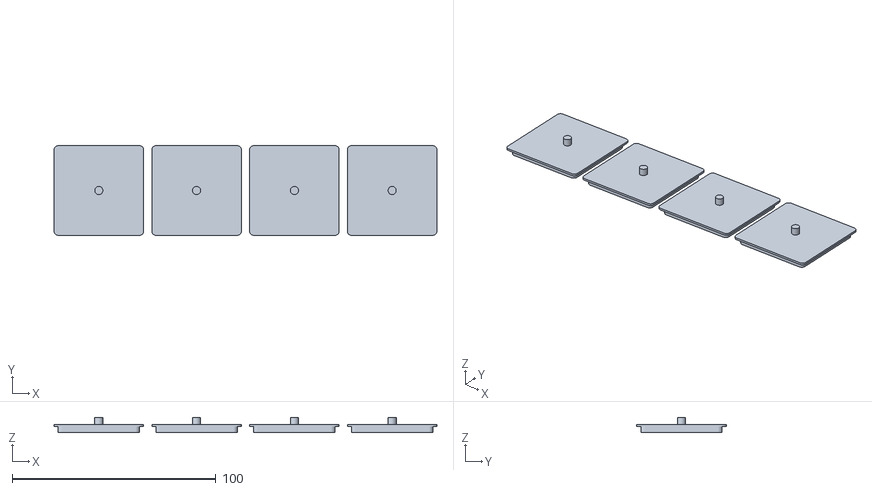
[picture p69: CAD file, 2026-11-01]
enclosure/print-ready/CP-100-four-caps-PRINT.stl
188.0 x 44.0 x 7.60
