dissakamajaya/cp-100/enclosure/stl/CP-100-pad-base.stl

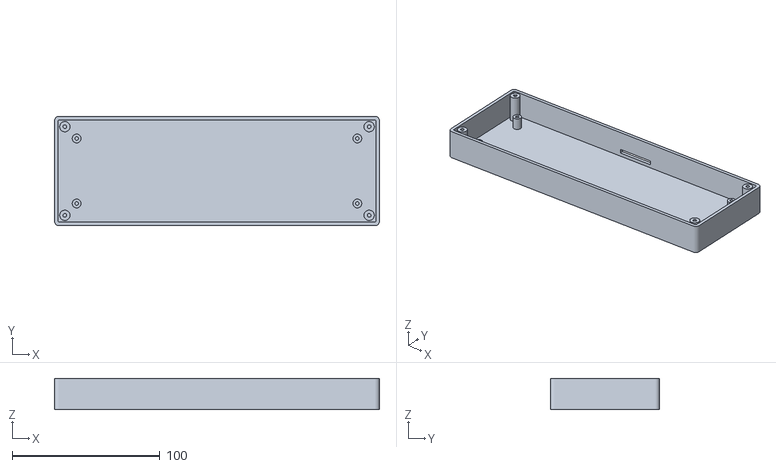
[picture p70: CAD file, 2026-11-01]
enclosure/stl/CP-100-pad-base.stl
220.0 x 74.0 x 21.0
