dissakamajaya/cp-100/enclosure/stl/CP-100-svc-knob-x3.stl

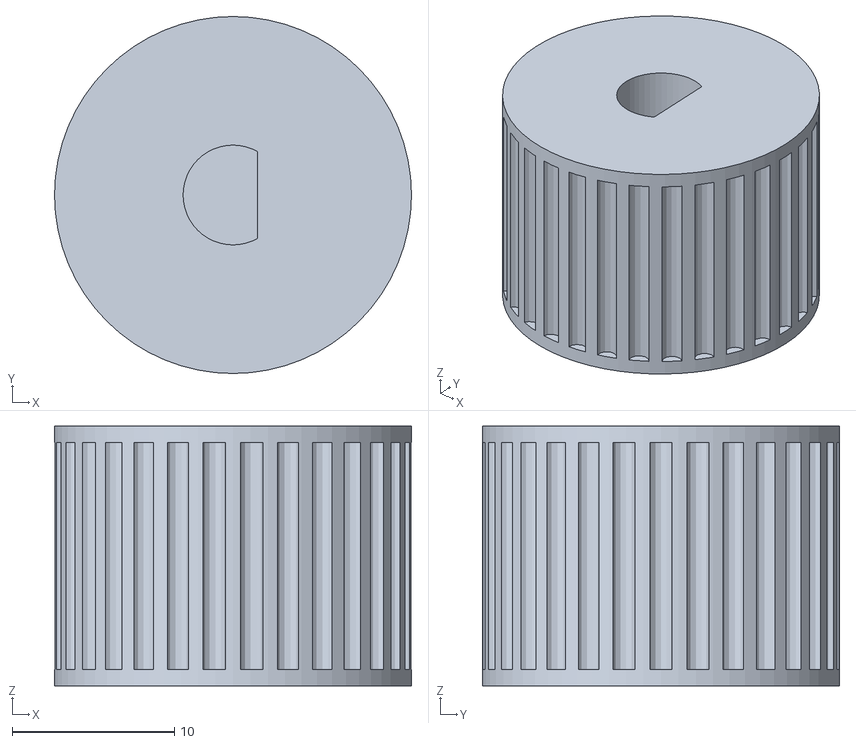
[picture p71: CAD file, 2026-11-01]
enclosure/stl/CP-100-svc-knob-x3.stl
22.0 x 22.0 x 16.0
