dissakamajaya/cp-100/enclosure/stl/CP-100-svc-box.stl

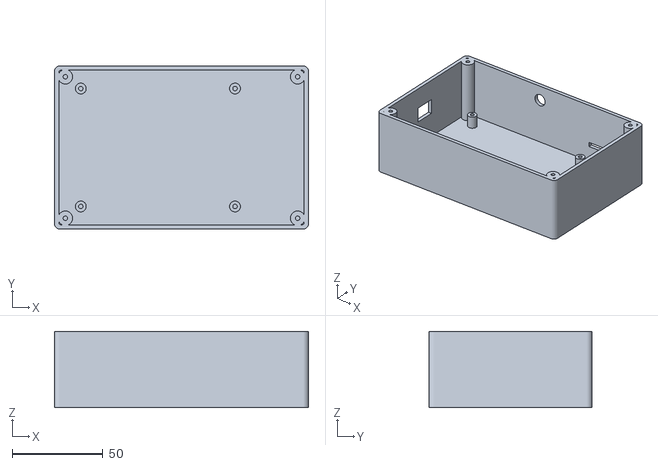
[picture p72: CAD file, 2026-11-01]
enclosure/stl/CP-100-svc-box.stl
140.0 x 90.0 x 42.0
