dissakamajaya/cp-100/enclosure/stl/CP-100-pad-cap-x4.stl

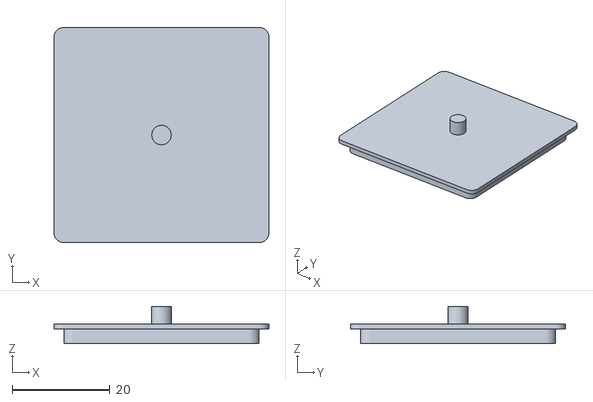
[picture p73: CAD file, 2026-11-01]
enclosure/stl/CP-100-pad-cap-x4.stl
44.0 x 44.0 x 7.60
