dissakamajaya/cp-100/enclosure/stl/CP-100-svc-button-x2.stl

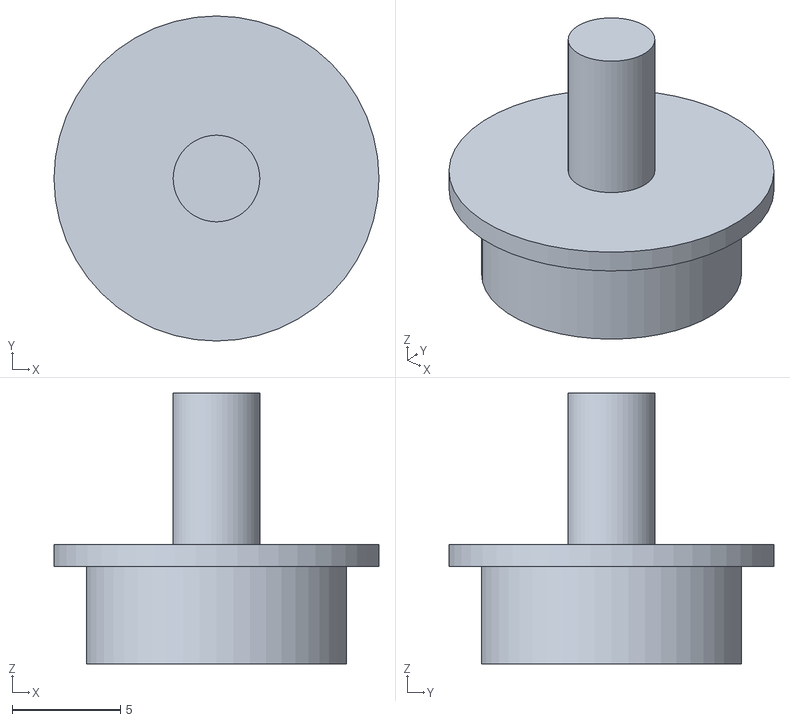
[picture p74: CAD file, 2026-11-01]
enclosure/stl/CP-100-svc-button-x2.stl
15.0 x 15.0 x 12.5
