dissakamajaya/cp-100/enclosure/stl/legacy-8-pad/CP-100-pad-top.stl

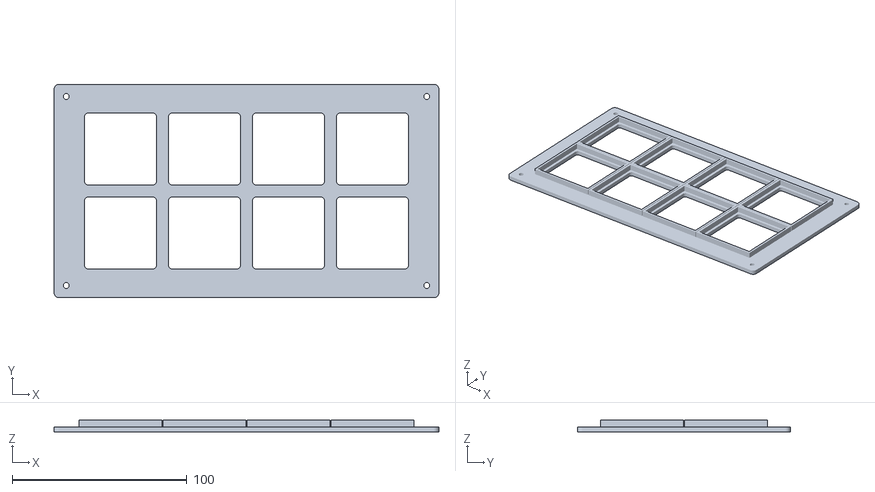
[picture p75: CAD file, 2026-11-01, an earlier design]
enclosure/stl/legacy-8-pad/CP-100-pad-top.stl
220.0 x 122.0 x 7.00
