dissakamajaya/cp-100/outputs/CP-100-Rev07-Desain-dan-Wiring.pdf

CP-100

# Instalasi


PELAT

# 60 x 60 cm

KACA

# Diameter 50 cm

CELAH

# 30 mm

30 mm

Beban: sepatu > kaca > casing.
Pelat bergetar tanpa beban kaca dan sepatu.

Tinggi casing acuan 35 cm. Tebal kaca, dudukan, dan celah final ditetapkan setelah uji rakitan.

# Panel dan operasi

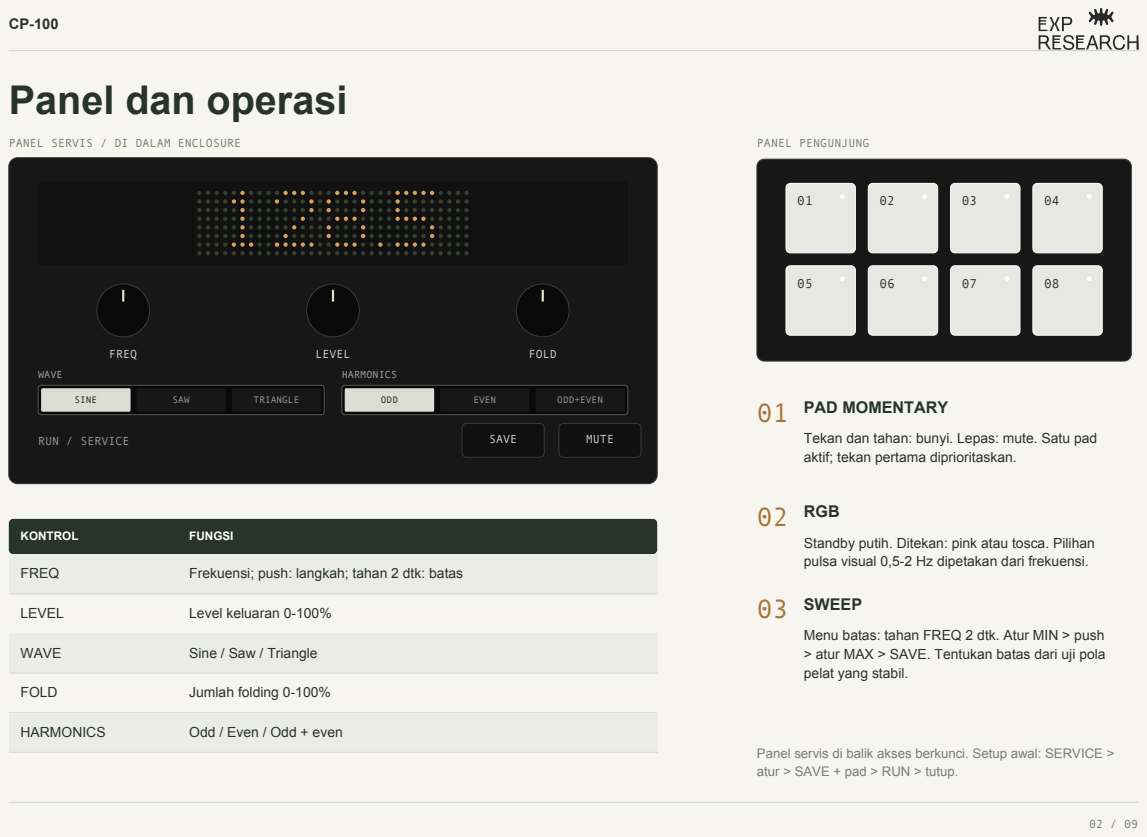
[picture p77: page 2]
PANEL SERVIS / DI DALAM ENCLOSURE; PANEL PENGUNJUNG; FREQ; LEVEL; FOLD; WAVE; SINE; SAW; TRIANGLE; HARMONICS; ODD; EVEN; ODD+EVEN; RUN / SERVICE; SAVE; MUTE; KONTROL; FUNGSI; Frekuensi; push: langkah; tahan 2 dtk: batas; Level keluaran 0-100%; Sine / Saw / Triangle; Jumlah folding 0-100%; Odd / Even / Odd + even; 01 PAD MOMENTARY; 02 RGB; 03 SWEEP

Tekan dan tahan: bunyi. Lepas: mute. Satu pad
aktif; tekan pertama diprioritaskan.

Standby putih. Ditekan: pink atau tosca. Pilihan
pulsa visual 0,5-2 Hz dipetakan dari frekuensi.

Menu batas: tahan FREQ 2 dtk. Atur MIN > push
> atur MAX > SAVE. Tentukan batas dari uji pola
pelat yang stabil.

Panel servis di balik akses berkunci. Setup awal: SERVICE >
atur > SAVE + pad > RUN > tutup.

# ESP32-S3 DevKitC-1 N16R8

## ESP32-S3

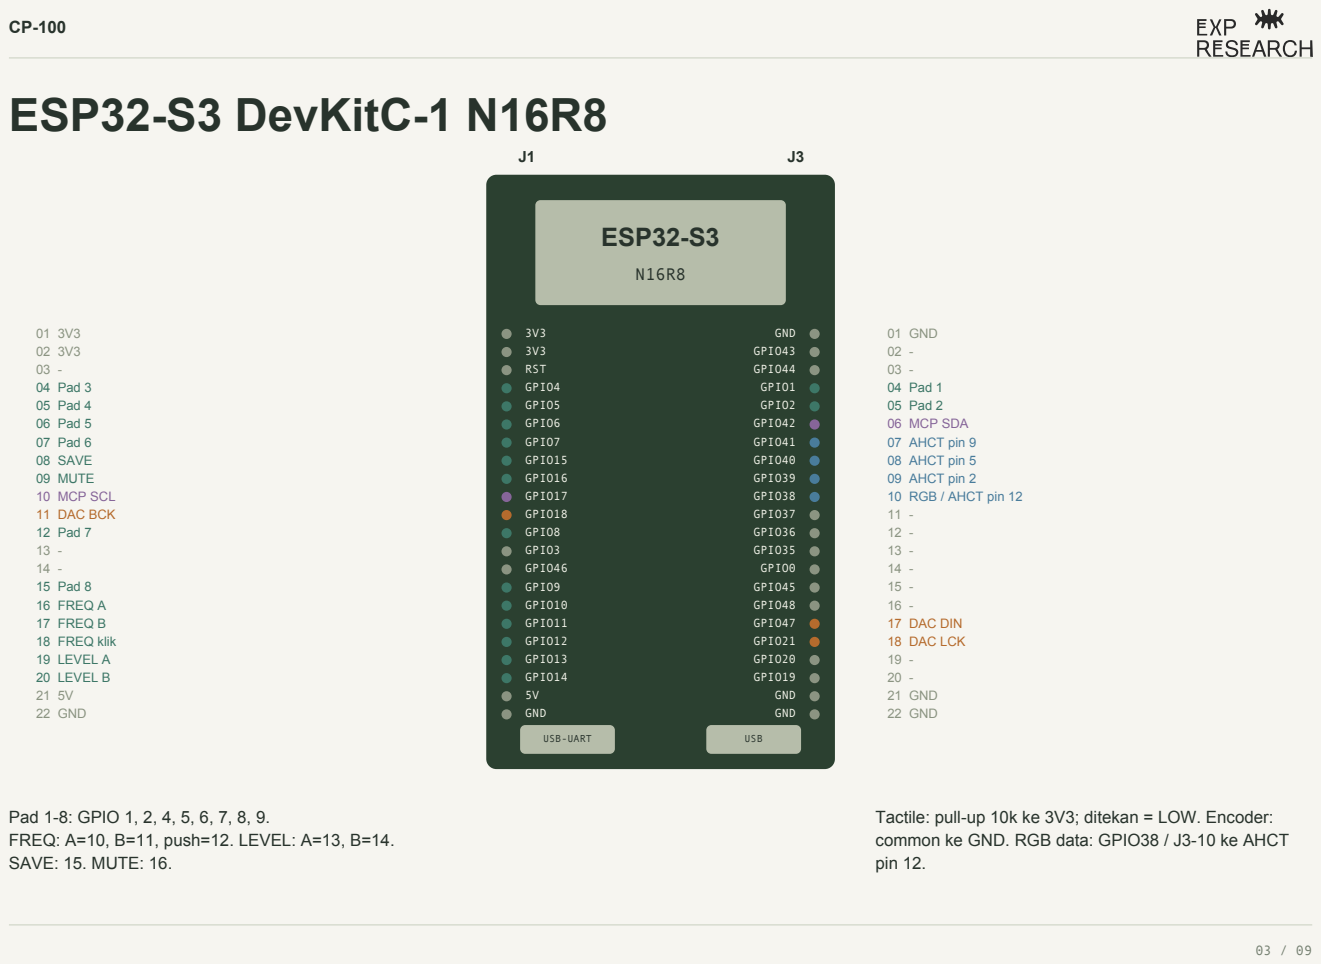
[picture p78: page 3]
GND; 01 GND; GPIO43; RST; GPIO44; 04 Pad 3; GPIO4; GPIO1; 04 Pad 1; 05 Pad 4; GPIO5; GPIO2; 05 Pad 2; 06 Pad 5; GPIO6; GPIO42; 06 MCP SDA; 07 Pad 6; GPIO7; GPIO41; 07 AHCT pin 9; 08 SAVE; GPIO15; GPIO40; 08 AHCT pin 5; 09 MUTE; GPIO16; GPIO39; 09 AHCT pin 2; 10 MCP SCL; GPIO17; GPIO38; 10 RGB / AHCT pin 12; 11 DAC BCK; GPIO18; GPIO37; 12 Pad 7; GPIO8; GPIO36; GPIO3; GPIO35; GPIO46; GPIO0; 15 Pad 8; GPIO9; GPIO45; 16 FREQ A; GPIO10; GPIO48; 17 FREQ B; GPIO11; GPIO47; 17 DAC DIN; 18 FREQ klik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

Pad 1-8: GPIO 1, 2, 4, 5, 6, 7, 8, 9.
FREQ: A=10, B=11, push=12. LEVEL: A=13, B=14.
SAVE: 15. MUTE: 16.

Tactile: pull-up 10k ke 3V3; ditekan = LOW. Encoder:
common ke GND. RGB data: GPIO38 / J3-10 ke AHCT
pin 12.

# Audio dan daya

ESP32 / CATU | GY-PCM5102
GPIO18 / J1-11 | BCK
GPIO47 / J3-17 | DIN
GPIO21 / J3-18 | LCK / LRCK
GND | SCK, FMT, DEMP, FLT, GND
3V3 | XSMT
5 V* | VIN / VCC

### GY-PCM5102 > YS-502MT AUX

TRS 3,5 mm: Tip=L, Ring=R, Sleeve=AGND. Kirim sinyal yang sama ke L dan R.

### YS-502MT > SHAKER

Gunakan satu kanal, misalnya L+ dan L-. L- / R- bukan GND. Jangan paralelkan kanal.

*5 V hanya untuk modul GY dengan regulator 3,3 V. Ikuti nama pin PCB. Tegangan adaptor dan impedansi shaker mengikuti label YS-502MT.

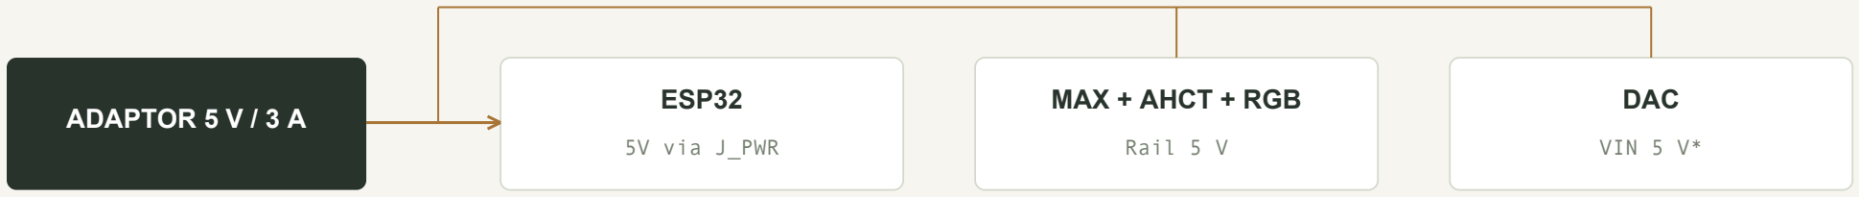
[picture p79: figure]
ADAPTOR 5 V / 3 A; ESP32; 5V via J_PWR; MAX + AHCT + RGB; Rail 5 V; DAC; VIN 5 V*

3V3 ESP32: MCP23017 dan pull-up. RGB: rail 5 V, anggaran 0,5 A untuk 8 LED. Amplifier: catu terpisah. USB programming: lepas J_PWR; periferal tetap memakai rail 5 V dan ground bersama.
Audio: I2S stereo 48 kHz, slot 32-bit / 64 Fs. Mulai dari MUTE dan level rendah.

# Display, RGB, dan ekspander

SN74AHCT125N / PDIP-14 | SAMBUNGAN
2 / 1A | GPIO39
3 / 1Y | MAX7219 DIN
5 / 2A | GPIO40
6 / 2Y | MAX7219 CLK
9 / 3A | GPIO41
8 / 3Y | MAX7219 CS / LOAD
14 / VCC | 5 V
7, 1, 4, 10 | GND
12 / 4A; 11 / 4Y; 13 / OE4 | GPIO38; RGB via 330R; GND
MCP23017-E/SP / SPDIP-28 | SAMBUNGAN
9 / VDD | 3V3
10 / VSS | GND
12 / SCL | GPIO17 / J1-10
13 / SDA | GPIO42 / J3-6
15, 16, 17 / A0-A2 | GND: alamat 0x20
18 / RESET | Pull-up 10k ke 3V3
1-8 / GPB0-GPB7 | Tanpa kabel; output LOW
11, 14, 19, 20 | Kosong
28 / GPA7 | Tanpa kabel; output LOW

MAX7219 quad 32 x 8: VCC 5 V, GND bersama; gunakan sisi IN. Decoupling: AHCT 100 nF; matrix 100 uF + 100 nF.
GPIO39/40: pull-down 10k. GPIO41: pull-up 10k ke 3V3.

RGB: 8 modul WS2812B, satu per pad. Rail 5 V / GND; DOUT ke DIN pad berikutnya. AHCT pin 11 > 330R > DIN pad 1.
Catu RGB: 470 uF pada input rail; 100 nF per LED.
I2C: pull-up 4,7k ke 3V3; MCP VDD-VSS 100 nF.
DevKit v1.1: LED onboard ikut data pad 1.

# WAVE, FOLD, dan HARMONICS

MCP23017 | PIN FISIK | KONTROL | POSISI / FUNGSI
GPA0 | 21 | RUN / SERVICE | HIGH=RUN; LOW=SERVICE
GPA1 | 22 | WAVE kontak 1 | LOW=SINE
GPA2 | 23 | WAVE kontak 3 | LOW=TRIANGLE; keduanya HIGH=SAW
GPA3 | 24 | HARMONICS kontak 1 | LOW=ODD
GPA4 | 25 | FOLD encoder A | A ke GPA4; common ke GND
GPA5 | 26 | FOLD encoder B | B ke GPA5; push tidak dipakai
GPA6 | 27 | HARMONICS kontak 3 | LOW=ODD+EVEN; keduanya HIGH=EVEN

WAVE dan HARMONICS: switch geser SP3T, 3 posisi tetap. COM ke GND. Kontak tengah tidak diberi kabel. Setiap jalur input memakai pull-up 10k ke 3V3. Dua input LOW bersamaan: tahan pilihan sah terakhir.

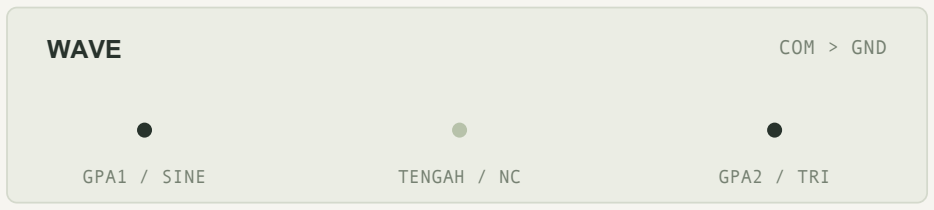
[picture p80: figure]
WAVE; COM > GND; GPA1 / SINE; TENGAH / NC; GPA2 / TRI
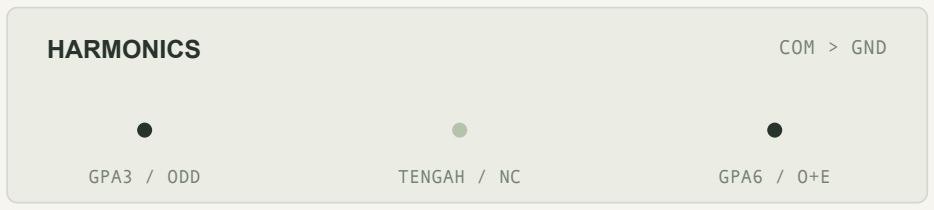
[picture p81: figure]
HARMONICS; COM > GND; GPA3 / ODD; TENGAH / NC; GPA6 / O+E

Boot: RUN + MUTE, LED putih. Debounce pad 10-20 ms; release menutup gate audio dengan ramp 5-10 ms.
Batas tersimpan: sweep berhenti di F_MIN/F_MAX; preset di luar batas diblokir. Nilai final menunggu uji pelat.
ESP32 (https://documentation.espressif.com/esp-dev-kits/en/latest/esp32s3/esp32-s3-devkitc-1/user_guide_v1.0.html) | PCM5102A (https://www.ti.com/lit/ds/symlink/pcm5102a.pdf) | AHCT125 (https://www.ti.com/lit/ds/symlink/sn74ahct125.pdf) | MCP23017 (https://ww1.microchip.com/downloads/aemDocuments/documents/APID/ProductDocuments/DataSheets/MCP23017-MCP23S17-16-Bit-IO-Expander-with-Serial-Interface-DS20001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) | MAX7219 (https://www.analog.com/media/en/technical-documentation/data-sheets/MAX7219-MAX7221.pdf) | WS2812B (https://www.world-semi.com/web/index.php?classid=302&id=299&lanstr=en&topclassid=16)

# Letak pintu servis

BELAKANG / AKSES STAFF

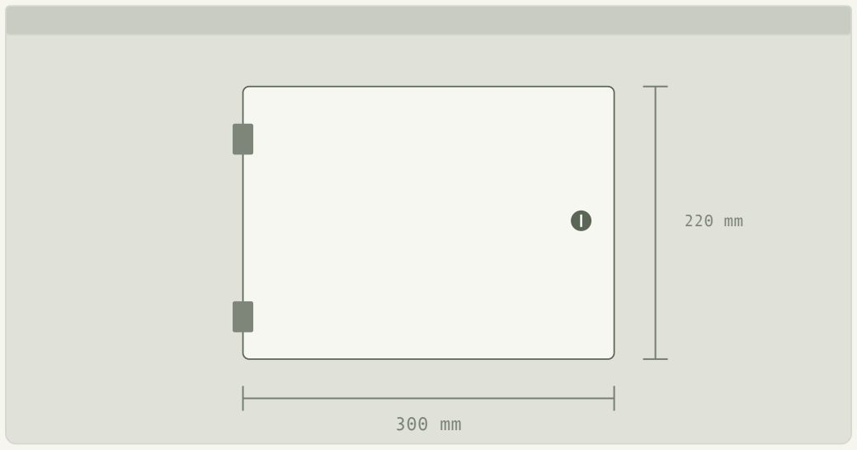
[picture p82: figure]

Pintu rata casing, engsel + kunci

Usulan bukaan 300 x 220 mm. Panel kontrol dipasang di dalam kompartemen servis; tidak tampak dari sisi pengunjung.

POTONGAN SAMPING / PINTU TERBUKA

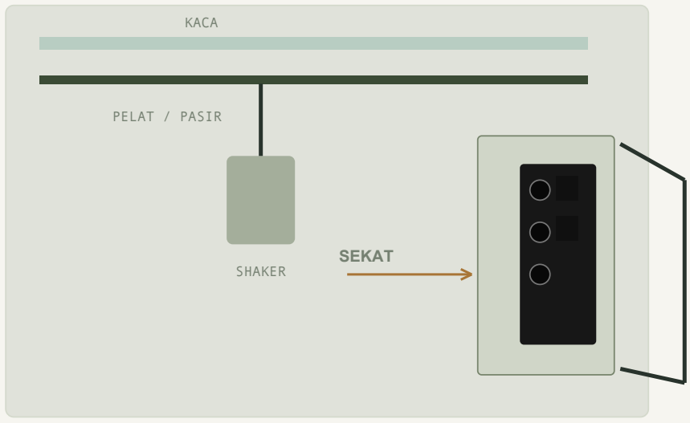
[picture p83: figure]
KACA; PELAT / PASIR; SEKAT; SHAKER

Kompartemen servis terpisah dari pasir. Kabel masuk melalui grommet. Panel dan engsel tidak menyentuh pelat atau shaker.

ORIENTASI

BELAKANG / PINTU

DEPAN / 8 PAD

# Komponen / elektronik

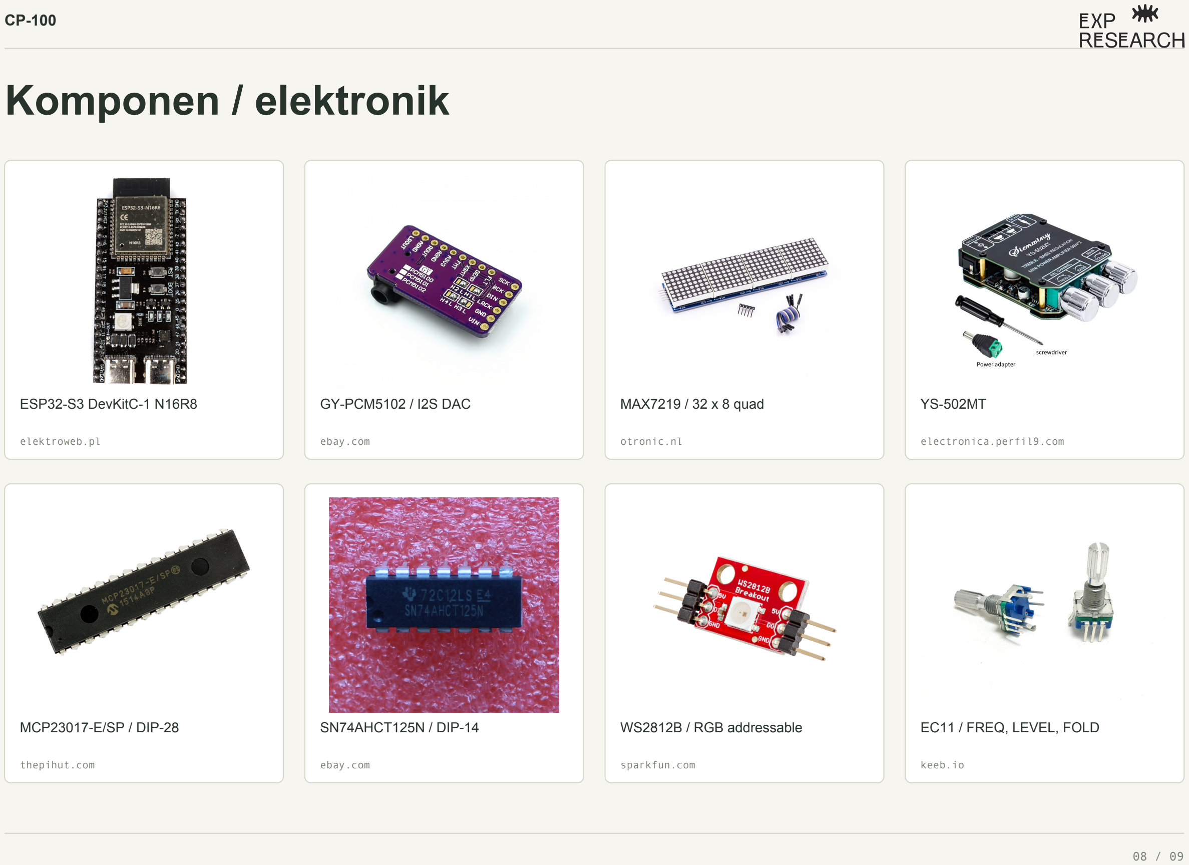
[picture p84: page 8]

ESP32-S3 DevKitC-1 N16R8

elektroweb.pl (https://elektroweb.pl/pl/esp32/1312-modul-esp32-s3-devkitc-1-wroom-1-n16r8-16mb-flash-wifi-bluetooth-usb-c.html)

GY-PCM5102 / I2S DAC

ebay.com (https://www.ebay.com/itm/314748193002)

MAX7219 / 32 x 8 quad

otronic.nl (https://www.otronic.nl/en/led-matrix-32x8-with-max7219-module.html)

YS-502MT

electronica.perfil9.com (https://electronica.perfil9.com/tienda/mini-amplificador-bluetooth-100w-hi-fi-2-0-estereo-2x50w-ys-502mt/)

MCP23017-E/SP / DIP-28

thepihut.com (https://thepihut.com/products/mcp23017-esp-io-expander)

SN74AHCT125N / DIP-14

ebay.com (https://www.ebay.com/itm/196424793180)

WS2812B / RGB addressable

sparkfun.com (https://www.sparkfun.com/sparkfun-rgb-led-breakout-ws2812b-with-headers.html)

EC11 / FREQ, LEVEL, FOLD

keeb.io (https://keeb.io/products/rotary-encoder-ec11)

# Komponen / kontrol dan koneksi

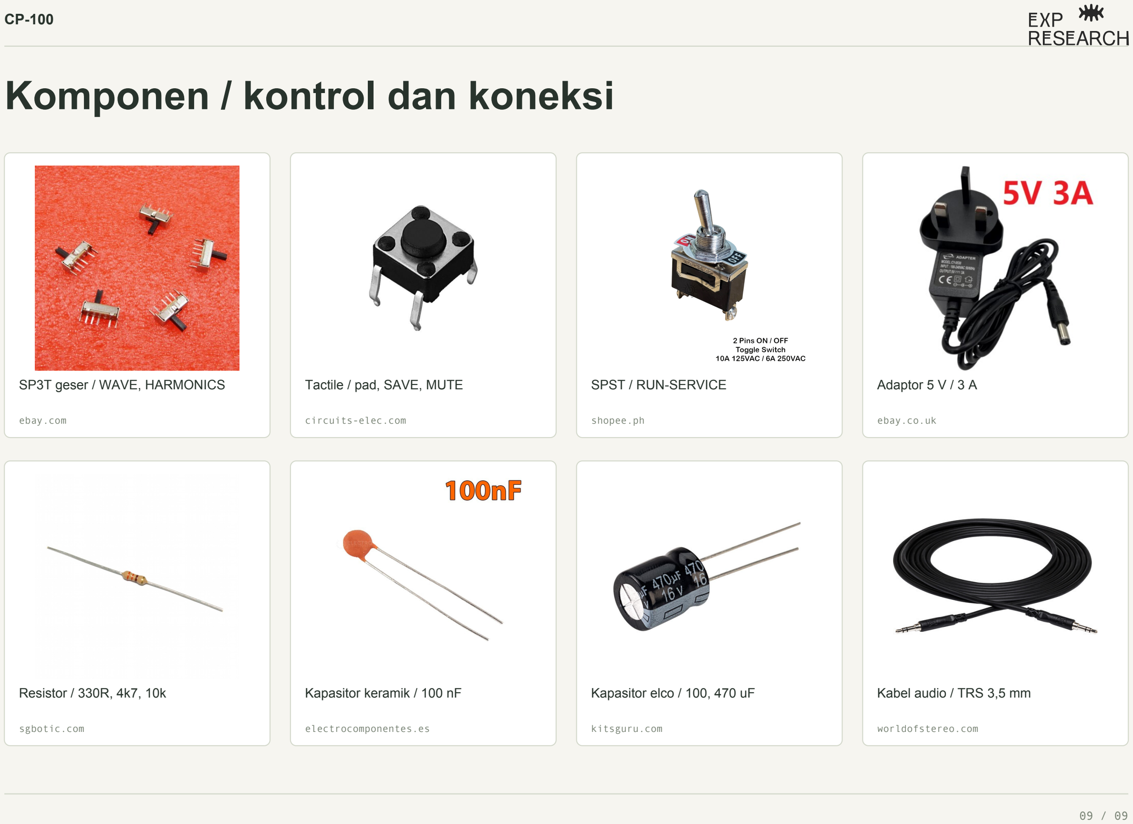
[picture p85: page 9]

SP3T geser / WAVE, HARMONICS

ebay.com (https://www.ebay.com/itm/373647240906)

Tactile / pad, SAVE, MUTE

circuits-elec.com (https://circuits-elec.com/products/push-button-6x6-4-pins)

SPST / RUN-SERVICE

shopee.ph (https://shopee.ph/Heavy-Duty-ON-and-OFF-2-PINS-SPST-Metal-Toggle-Rocker-Power-Switch-6A-250V-AC-i.33695347.28883796977)

Adaptor 5 V / 3 A

ebay.co.uk (https://www.ebay.co.uk/itm/305198934952)

Resistor / 330R, 4k7, 10k

sgbotic.com (https://www.sgbotic.com/index.php?dispatch=products.view&product_id=791)

Kapasitor keramik / 100 nF

electrocomponentes.es (https://www.electrocomponentes.es/ceramicos/94-condensador-ceramico-100nf-50v.html)

Kapasitor elco / 100, 470 uF

kitsguru.com (https://kitsguru.com/products/470uf-16v-electrolytic-capacitor-6-12mm-lead-space-3mm)

Kabel audio / TRS 3,5 mm

worldofstereo.com (https://worldofstereo.com/hosa-cmm-103-stereo-interconnect-cable-3-5mm-trs-male-to-3-5mm-trs-male-3-foot/)
