dissakamajaya/cp-100/enclosure/print-ready/CP-100-4-pad-vendor-preview.png

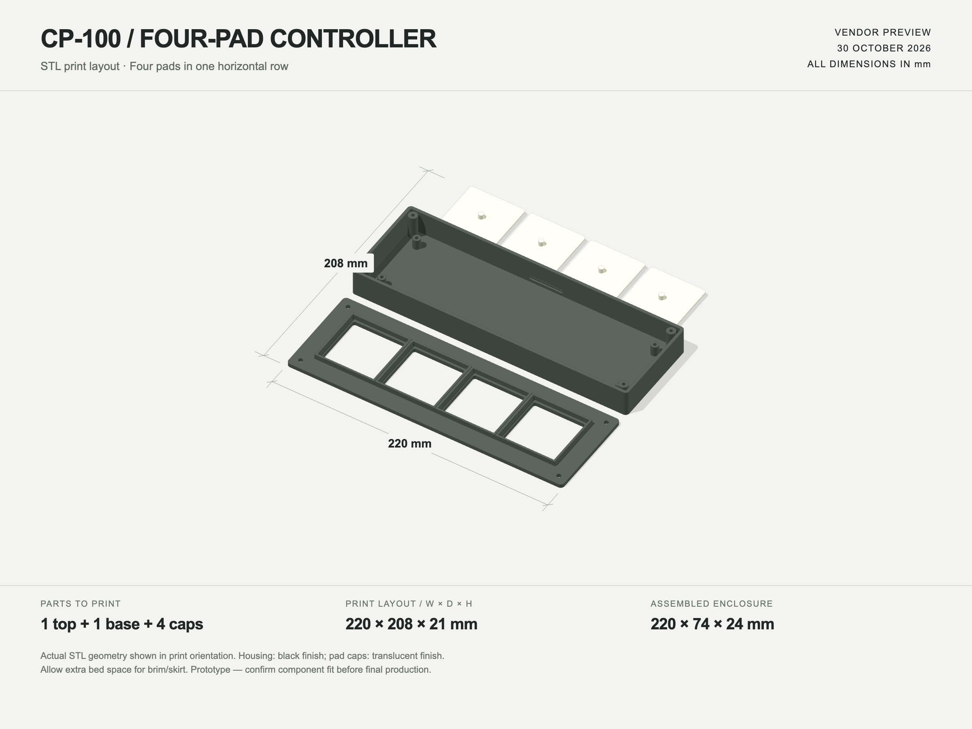
enclosure/print-ready/CP-100-4-pad-vendor-preview.png
