dissakamajaya/cp-100/evidence/release-2026-11-01/wiring-1.png

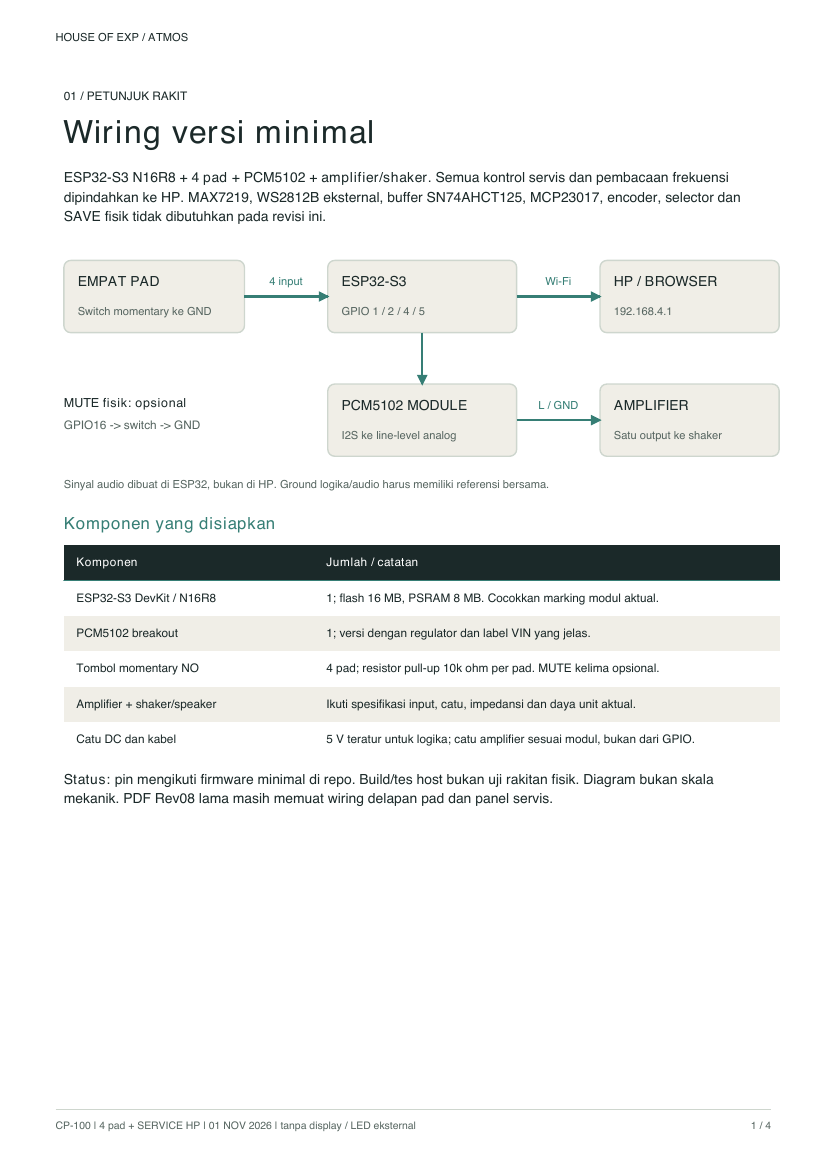
evidence/release-2026-11-01/wiring-1.png
