dissakamajaya/cp-100/evidence/release-2026-11-01/wiring-4.png

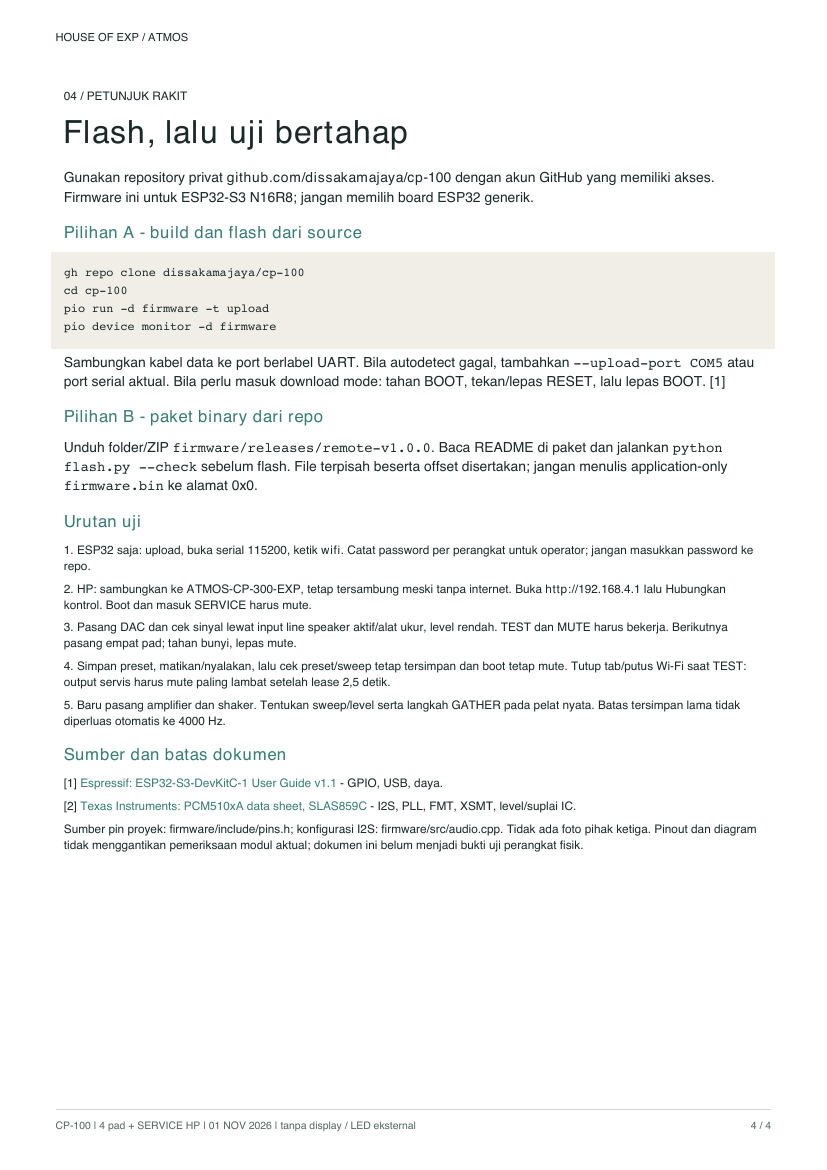
evidence/release-2026-11-01/wiring-4.png
