dissakamajaya/cp-100/evidence/momentary-2026-11-01/simulator-router-tests.txt

✔ canonical slash redirect preserves query (71.633375ms)
✔ module, PDF and root paths map to the fixed upstream and strip credentials (4.640459ms)
✔ simulator redirect stays under custom prefix; external redirect stays external (0.683458ms)
✔ sibling slug and main-site requests fall through unchanged (0.907833ms)
✔ write requests are rejected without forwarding; HEAD has no body (0.343916ms)
✔ upstream failure returns uncached 502 (0.577833ms)
✔ rapid continuous sweep automates frequency without zeroing gain, replacing curves, restarting oscillators, or rebuilding nodes (13.289875ms)
✔ folder and three-position selector adjust live AudioParams; MUTE and audio-off alone target zero output (18.799334ms)
✔ top-row and numpad 1–8 map to pads, including Num Lock off (6.164625ms)
✔ 4000 Hz and fractional fold survive save/export/import and recall (7.7755ms)
✔ existing 2000 Hz sweep bounds and calibrated custom limits stay intact (1.022ms)
✔ first glide fades in, later glides move exponentially in frequency and linearly in level, then fade out (5.503333ms)
✔ zero-length glides jump straight to the hold value (0.234208ms)
✔ validation rejects bad routines atomically and the file round-trips (5.08975ms)
✔ player plays once at frame rate, then reports done and stops scheduling (1.254875ms)
✔ stop cancels pending frames, including stale callbacks, without calling done (0.259292ms)
✔ GATHER_FRAME drives a plain sine in SERVICE only, clamps to sweep limits and leaves presets alone (0.894834ms)
✔ sand field follows frequency, wave and harmonic selector and remains finite (29.027875ms)
✔ sand animation keeps grains inside the glass window under prolonged excitation (38.687208ms)
✔ settled sand keeps granular nodal bands across presets without piling onto the rim (485.293041ms)
✔ frequency change moves existing grains toward a new pattern rather than teleporting them (29.678625ms)
✔ scene geometry matches the final 60 cm plate and 50 cm glass (0.246375ms)
✔ ordered sequence starts at pad 1, holds each for 3000 ms and loops all eight (6.86375ms)
✔ random mode visits every pad once per cycle and avoids immediate repeats across cycles (0.35325ms)
✔ stop and restart cancel pending ticks, including callbacks already queued by the event loop (0.21525ms)
✔ empty and excluded slots are silent for their full step and never keep the previous pad playing (0.41025ms)
✔ a step callback can stop playback without scheduling another tick (0.075125ms)
✔ sequence steps disarm SAVE without changing presets and replace the current pad atomically (0.161833ms)
✔ RUN cannot change parameters or arm SAVE (2.434459ms)
✔ SAVE captures five independent parameters, persists, and recalls after a muted reboot (1.171625ms)
✔ leaving SERVICE cancels an armed save and mutes; a subsequent pad recalls rather than overwrites (0.214292ms)
✔ empty pad does not start or alter output (0.181834ms)
✔ invalid import is atomic and rejects unsupported waves, bad slot counts, and nonfinite levels (0.623083ms)
✔ fold zero is an exact bypass and folding remains odd and bounded (4.782958ms)
✔ normalization holds the signal RMS across waves and folding while preserving peak headroom and zero DC (52.244708ms)
✔ folding a sine adds a measurable third harmonic (2.798292ms)
✔ asymmetric folding adds even harmonics and removes DC; symmetric sine remains odd (7.580958ms)
✔ folding really reflects after the threshold instead of saturating (0.129792ms)
✔ EVEN adds even harmonics while retaining the sine fundamental and no added odd harmonics (3.762583ms)
✔ version 3 presets migrate explicitly to three-position harmonics without losing slot data (0.119ms)
✔ momentary pad release mutes, clears active pad, and cannot resume via RUN mute button (0.076709ms)
✔ first held pad owns output; other press and release cannot steal or silence it (0.056625ms)
✔ commissioned sweep limits clamp editing, reject excluded presets and survive reboot (0.309416ms)
✔ RGB pads are white at standby, pink/tosca while held, and optional pulse stays in visual range (0.242375ms)
ℹ tests 44
ℹ suites 0
ℹ pass 44
ℹ fail 0
ℹ cancelled 0
ℹ skipped 0
ℹ todo 0
ℹ duration_ms 679.075792
