dissakamajaya/cp-100/evidence/release-2026-11-01/simulator-router-tests.txt

✔ canonical slash redirect preserves query (26.75475ms)
✔ module, PDF and root paths map to the fixed upstream and strip credentials (4.833875ms)
✔ simulator redirect stays under custom prefix; external redirect stays external (0.560666ms)
✔ sibling slug and main-site requests fall through unchanged (0.940084ms)
✔ write requests are rejected without forwarding; HEAD has no body (0.585ms)
✔ upstream failure returns uncached 502 (0.184542ms)
✔ rapid continuous sweep automates frequency without zeroing gain, replacing curves, restarting oscillators, or rebuilding nodes (4.941667ms)
✔ folder and three-position selector adjust live AudioParams; MUTE and audio-off alone target zero output (19.664791ms)
✔ top-row and numpad 1–8 map to pads, including Num Lock off (2.606083ms)
✔ 4000 Hz and fractional fold survive save/export/import and recall (2.286791ms)
✔ existing 2000 Hz sweep bounds and calibrated custom limits stay intact (0.459875ms)
✔ first glide fades in, later glides move exponentially in frequency and linearly in level, then fade out (1.765125ms)
✔ zero-length glides jump straight to the hold value (0.09025ms)
✔ validation rejects bad routines atomically and the file round-trips (0.376917ms)
✔ player plays once at frame rate, then reports done and stops scheduling (1.823917ms)
✔ stop cancels pending frames, including stale callbacks, without calling done (0.218584ms)
✔ GATHER_FRAME drives a plain sine in SERVICE only, clamps to sweep limits and leaves presets alone (0.474208ms)
✔ sand field follows frequency, wave and harmonic selector and remains finite (39.063458ms)
✔ sand animation keeps grains inside the glass window under prolonged excitation (24.880875ms)
✔ settled sand keeps granular nodal bands across presets without piling onto the rim (419.072417ms)
✔ frequency change moves existing grains toward a new pattern rather than teleporting them (27.270042ms)
✔ scene geometry matches the final 60 cm plate and 50 cm glass (0.205625ms)
✔ ordered sequence starts at pad 1, holds each for 3000 ms and loops all eight (1.99875ms)
✔ random mode visits every pad once per cycle and avoids immediate repeats across cycles (0.289584ms)
✔ stop and restart cancel pending ticks, including callbacks already queued by the event loop (0.200917ms)
✔ empty and excluded slots are silent for their full step and never keep the previous pad playing (0.441042ms)
✔ a step callback can stop playback without scheduling another tick (0.078541ms)
✔ sequence steps disarm SAVE without changing presets and replace the current pad atomically (0.113083ms)
✔ RUN cannot change parameters or arm SAVE (1.887208ms)
✔ SAVE captures five independent parameters, persists, and recalls after a muted reboot (1.114125ms)
✔ leaving SERVICE cancels an armed save and mutes; a subsequent pad recalls rather than overwrites (0.206666ms)
✔ empty pad does not start or alter output (0.177792ms)
✔ invalid import is atomic and rejects unsupported waves, bad slot counts, and nonfinite levels (0.594667ms)
✔ fold zero is an exact bypass and folding remains odd and bounded (1.604833ms)
✔ normalization holds the signal RMS across waves and folding while preserving peak headroom and zero DC (37.664459ms)
✔ folding a sine adds a measurable third harmonic (1.667958ms)
✔ asymmetric folding adds even harmonics and removes DC; symmetric sine remains odd (5.1165ms)
✔ folding really reflects after the threshold instead of saturating (0.105542ms)
✔ EVEN adds even harmonics while retaining the sine fundamental and no added odd harmonics (2.207167ms)
✔ version 3 presets migrate explicitly to three-position harmonics without losing slot data (0.100916ms)
✔ momentary pad release mutes, clears active pad, and cannot resume via RUN mute button (0.0845ms)
✔ first held pad owns output; other press and release cannot steal or silence it (0.059083ms)
✔ commissioned sweep limits clamp editing, reject excluded presets and survive reboot (0.171125ms)
✔ RGB pads are white at standby, pink/tosca while held, and optional pulse stays in visual range (0.227417ms)
ℹ tests 44
ℹ suites 0
ℹ pass 44
ℹ fail 0
ℹ cancelled 0
ℹ skipped 0
ℹ todo 0
ℹ duration_ms 591.542333
