dissakamajaya/cp-100/evidence/gather-2026-10-28/tests.txt

✔ canonical slash redirect preserves query (70.371875ms)
✔ module, PDF and root paths map to the fixed upstream and strip credentials (3.155083ms)
✔ simulator redirect stays under custom prefix; external redirect stays external (0.367542ms)
✔ sibling slug and main-site requests fall through unchanged (0.345417ms)
✔ write requests are rejected without forwarding; HEAD has no body (0.228958ms)
✔ upstream failure returns uncached 502 (0.161458ms)
✔ rapid continuous sweep automates frequency without zeroing gain, replacing curves, restarting oscillators, or rebuilding nodes (8.074417ms)
✔ folder and three-position selector adjust live AudioParams; MUTE and audio-off alone target zero output (14.9215ms)
✔ top-row and numpad 1–8 map to pads, including Num Lock off (3.114375ms)
✔ 4000 Hz and fractional fold survive save/export/import and recall (4.969666ms)
✔ existing 2000 Hz sweep bounds and calibrated custom limits stay intact (0.592375ms)
✔ first glide fades in, later glides move exponentially in frequency and linearly in level, then fade out (2.174292ms)
✔ zero-length glides jump straight to the hold value (0.130208ms)
✔ validation rejects bad routines atomically and the file round-trips (1.941208ms)
✔ player plays once at frame rate, then reports done and stops scheduling (1.249667ms)
✔ stop cancels pending frames, including stale callbacks, without calling done (0.194542ms)
✔ GATHER_FRAME drives a plain sine in SERVICE only, clamps to sweep limits and leaves presets alone (0.768125ms)
✔ sand field follows frequency, wave and harmonic selector and remains finite (53.543125ms)
✔ sand animation keeps grains inside the glass window under prolonged excitation (33.459709ms)
✔ settled sand keeps granular nodal bands across presets without piling onto the rim (458.51475ms)
✔ frequency change moves existing grains toward a new pattern rather than teleporting them (30.702125ms)
✔ scene geometry matches the final 60 cm plate and 50 cm glass (0.286833ms)
✔ ordered sequence starts at pad 1, holds each for 3000 ms and loops all eight (2.385708ms)
✔ random mode visits every pad once per cycle and avoids immediate repeats across cycles (0.28025ms)
✔ stop and restart cancel pending ticks, including callbacks already queued by the event loop (0.379458ms)
✔ empty and excluded slots are silent for their full step and never keep the previous pad playing (1.018708ms)
✔ a step callback can stop playback without scheduling another tick (0.121667ms)
✔ sequence steps disarm SAVE without changing presets and replace the current pad atomically (0.122916ms)
✔ RUN cannot change parameters or arm SAVE (1.851875ms)
✔ SAVE captures five independent parameters, persists, and recalls after a muted reboot (1.072917ms)
✔ leaving SERVICE cancels an armed save and mutes; a subsequent pad recalls rather than overwrites (0.330375ms)
✔ empty pad does not start or alter output (0.189542ms)
✔ invalid import is atomic and rejects unsupported waves, bad slot counts, and nonfinite levels (0.471208ms)
✔ fold zero is an exact bypass and folding remains odd and bounded (2.493167ms)
✔ normalization holds the signal RMS across waves and folding while preserving peak headroom and zero DC (55.127625ms)
✔ folding a sine adds a measurable third harmonic (2.606792ms)
✔ asymmetric folding adds even harmonics and removes DC; symmetric sine remains odd (5.916209ms)
✔ folding really reflects after the threshold instead of saturating (0.263417ms)
✔ EVEN adds even harmonics while retaining the sine fundamental and no added odd harmonics (3.3265ms)
✔ version 3 presets migrate explicitly to three-position harmonics without losing slot data (0.124541ms)
✔ momentary pad release mutes, clears active pad, and cannot resume via RUN mute button (0.079375ms)
✔ first held pad owns output; other press and release cannot steal or silence it (0.057125ms)
✔ commissioned sweep limits clamp editing, reject excluded presets and survive reboot (0.300333ms)
✔ RGB pads are white at standby, pink/tosca while held, and optional pulse stays in visual range (0.26525ms)
ℹ tests 44
ℹ suites 0
ℹ pass 44
ℹ fail 0
ℹ cancelled 0
ℹ skipped 0
ℹ todo 0
ℹ duration_ms 663.218042
