dissakamajaya/cp-100/requirements-pdf-tested.txt

charset-normalizer==3.5.2
cssselect2==0.10.1
lxml==6.1.3
pillow==13.0.0
pypdf==6.21.2
reportlab==4.5.1
svglib==2.3.2
tinycss2==1.5.1
webencodings==0.6.1
