dissakamajaya/cp-100/evidence/momentary-2026-11-01/host-tests.txt

all checks passed
419 checks, 0 failures
