dissakamajaya/cp-100/evidence/release-2026-11-01/host-tests.txt

all checks passed
326 checks, 0 failures
