dissakamajaya/cp-100/evidence/historical/domain-route/momentary-maintenance.png

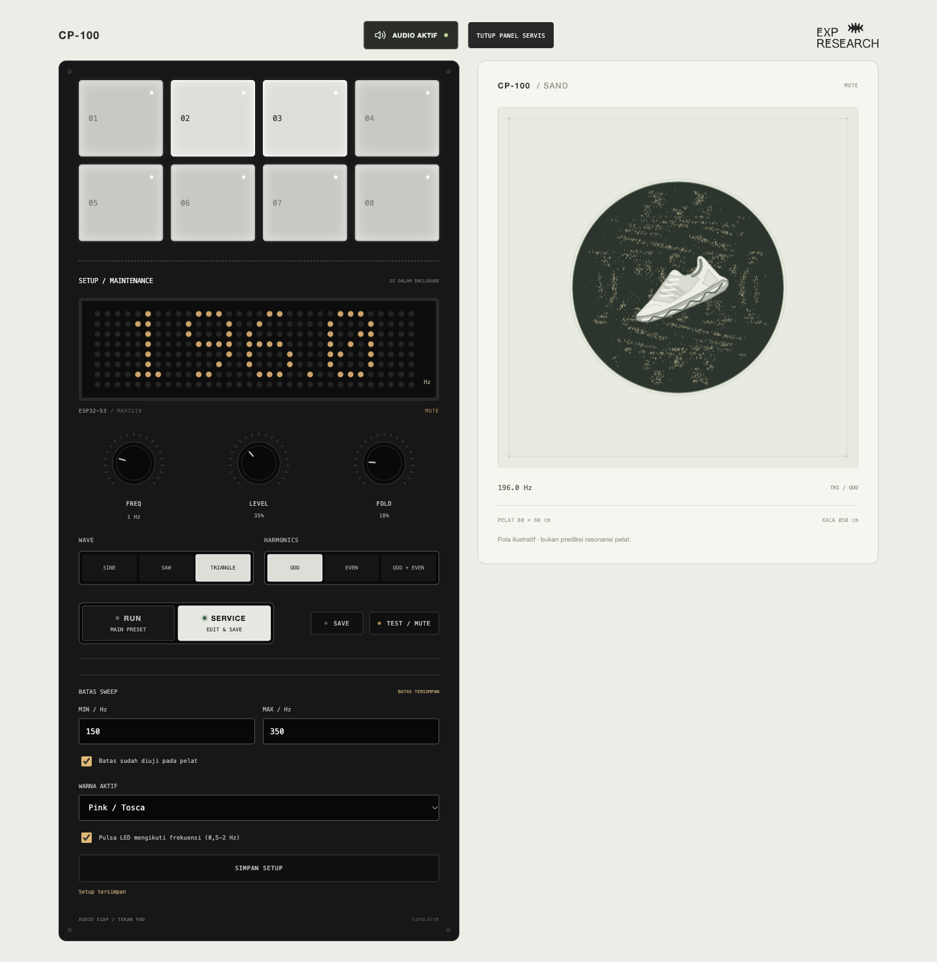
evidence/historical/domain-route/momentary-maintenance.png
