dissakamajaya/cp-100/(commit log)

2026-10-26 Consolidate CP-100 sources, blueprints and agent handoff
    [CP-100-Rev07-Pinout.csv, CP-100-Rev08-Pinout.csv, cutout-coordinates-mm.csv, service-cutout-1to1.dxf, visitor-cutout-1to1.dxf]
2026-10-26 Extend simulator to 4000 Hz and refine frequency, fold and keypad controls
2026-11-01 Add minimal four-pad Wi-Fi firmware, flash package and wiring guide
    [CP-100-4-pad-horizontal-PRINT.stl, CP-100-Wiring-4-Pad-WiFi.csv, CP-100-four-caps-PRINT.stl, CP-100-housing-PRINT.stl, CP-100-pad-base.stl, CP-100-pad-cap-x4.stl, CP-100-pad-cap-x8.stl, CP-100-pad-top.stl]
2026-11-01 Add DevKit photos and physical wiring diagrams to PDF Rev02
2026-11-01 Limit manual pads to five seconds and set operator presets and hotspot
    [CP-100-Wiring-4-Pad-WiFi.csv]
2026-11-01 Add DAC jumper, bench power and venv steps to wiring PDF Rev04
    Firmware unchanged; clean rebuild is byte-identical to the v1.1.0 images.
